CowboyTim/halloween-bang/docs/61XBP4-2t9L._AC_SL1001_.jpg

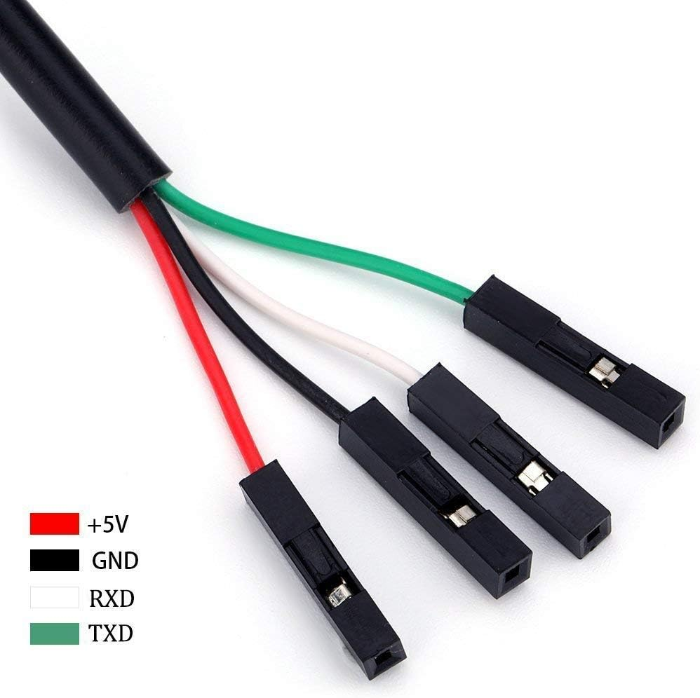
docs/61XBP4-2t9L._AC_SL1001_.jpg
