CowboyTim/halloween-bang/docs/2n2222-npn-transistor-pinout-diagram.jpg

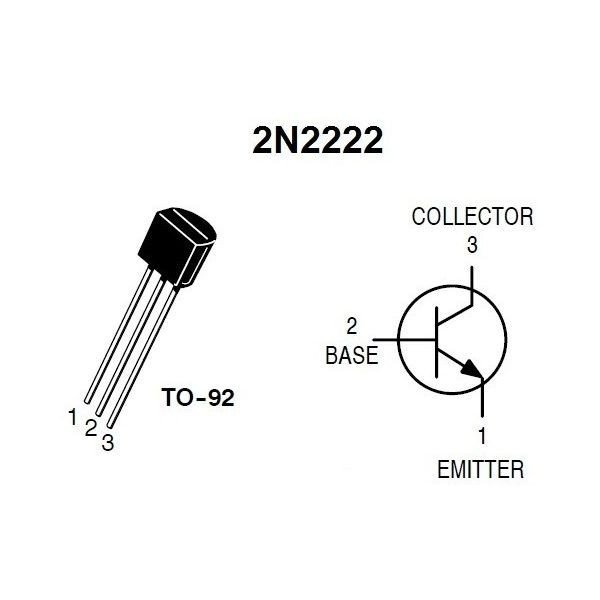
docs/2n2222-npn-transistor-pinout-diagram.jpg
