CowboyTim/halloween-bang/docs/button_schema.jpeg

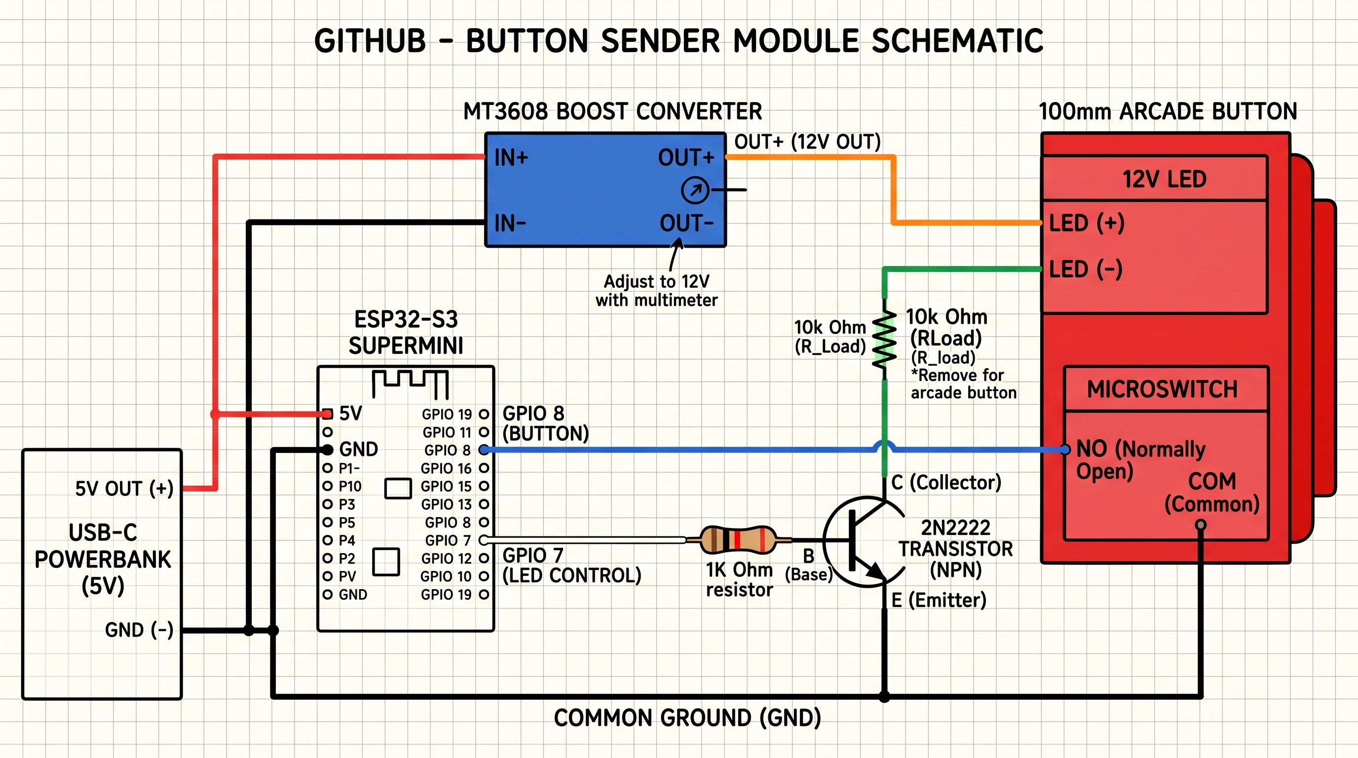
docs/button_schema.jpeg
