CowboyTim/halloween-bang/docs/dfplayer_pinout.webp

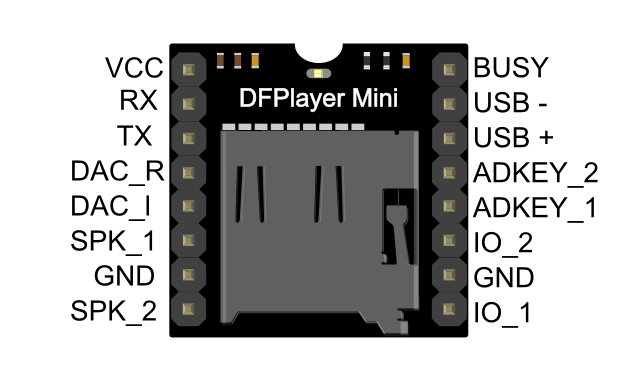
docs/dfplayer_pinout.webp
