CowboyTim/halloween-bang/docs/esp32s3_supermini_pinout.png

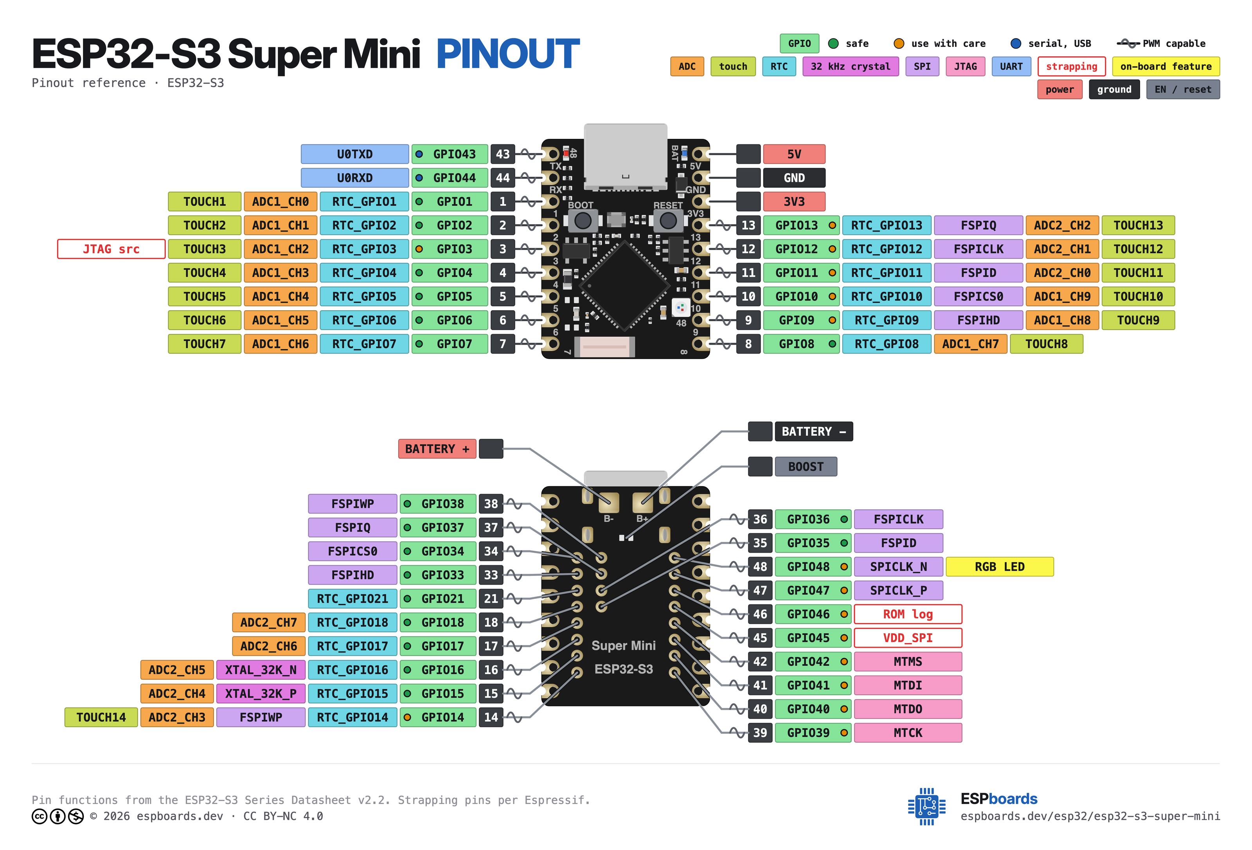
docs/esp32s3_supermini_pinout.png
