CowboyTim/halloween-bang/docs/onoff-button-white-led.jpg

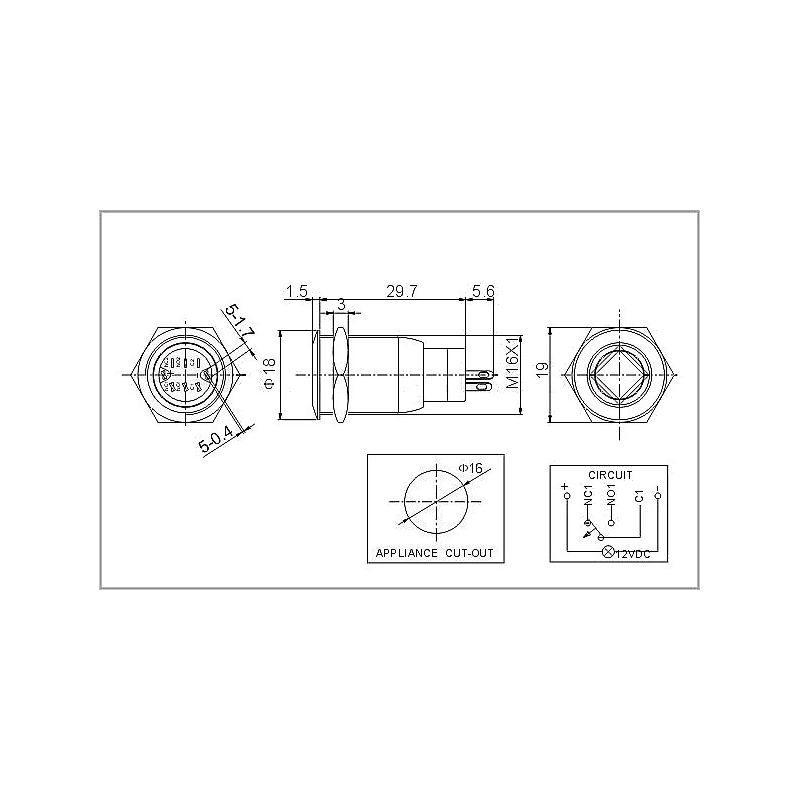
docs/onoff-button-white-led.jpg
