CowboyTim/halloween-bang/esp32s3_zero.pinout.png

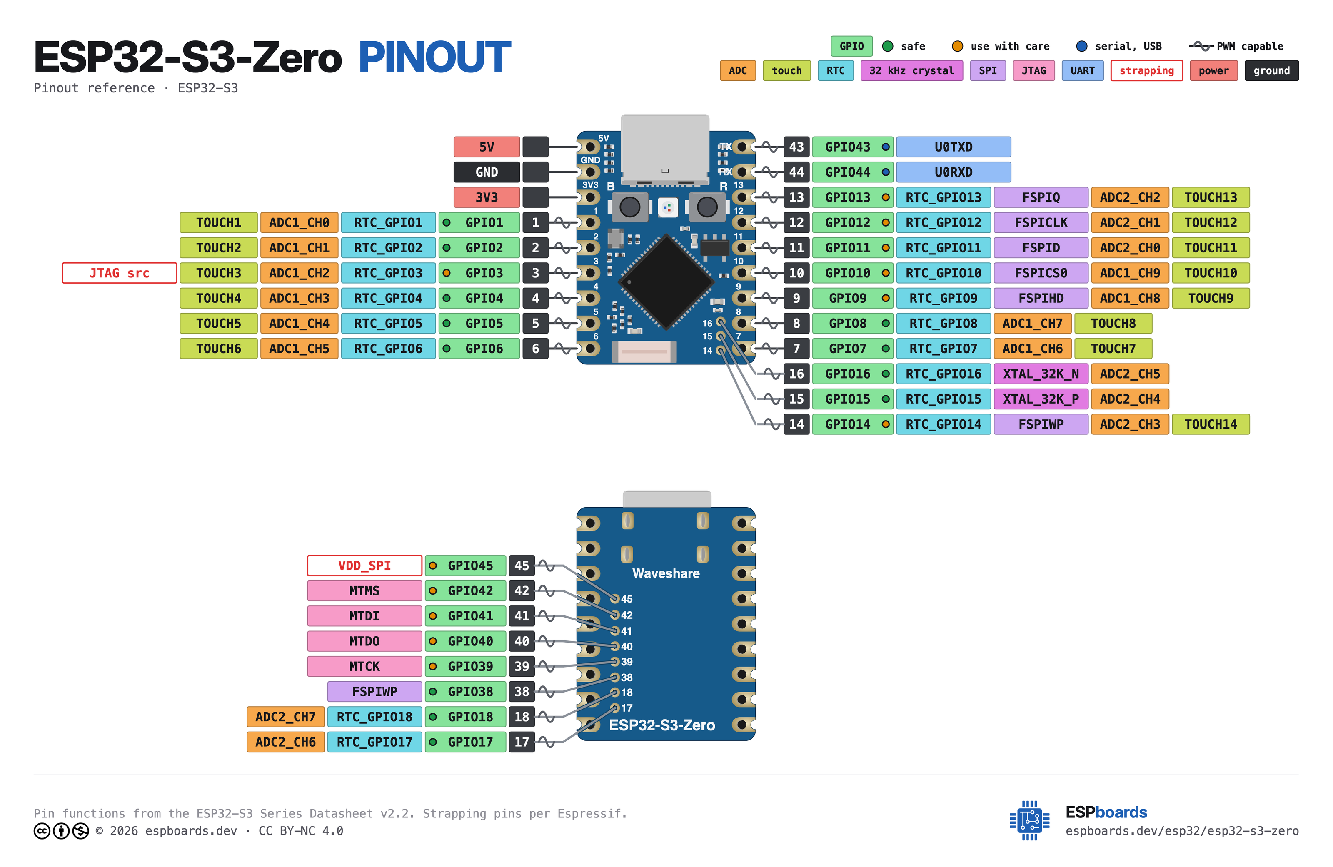
esp32s3_zero.pinout.png
