CowboyTim/halloween-bang/halloween-bang/halloween-bang.ino

#ifndef UART_LOG_DEV_UART0
#define UART_LOG_DEV_UART0 0
#endif

#if UART_LOG_DEV_UART0 == 1
 #define NO_GLOBAL_INSTANCES
 #define NO_GLOBAL_SERIAL
 #include <HardwareSerial.h>
 extern HardwareSerial Serial0;
 extern HardwareSerial Serial1;
 #define UART0         Serial0
 #define Serial        Serial0
 #define UART1         Serial1
#else
 #include <HardwareSerial.h>
 #define UART0         Serial
 #define UART1         Serial1
#endif // UART_LOG_DEV_UART0

// 433 MHz link (RadioHead): only the BUTTON (receiver) uses it. The KILLSWITCH has no STX882 fitted,
// so it sends over ESP-NOW only (its 433 MHz transmit path is compiled out).
#if defined(BUTTON)
#define USE_RF433 1
#else
#define USE_RF433 0
#endif

#include <stdlib.h>
#include "EdSoftLED.h"
#if defined(ESP8266)
  #include <ESP8266WiFi.h>
  #include <espnow.h>
  #error "This board is not supported or is missing Wi-Fi hardware!"
#elif defined(ESP32)
  #include <WiFi.h>
  #include <esp_wifi.h>
  #include <esp_now.h>
  #include <driver/gpio.h>
  #include <driver/rmt.h>
  #include <esp_task_wdt.h>
  #include <soc/gpio_struct.h>
  #if USE_RF433
  #include <RH_ASK.h>        // 433 MHz ASK link (STX882 / SRX882): a second path for LOCK / FREE
  #include <SPI.h>
  #endif
  #include <esp_rom_sys.h>
  // ESP32 fallback if needed
#else
  #error "This board is not supported or is missing Wi-Fi hardware!"
#endif

#include "HardwareSerial.h"
// The BANGER has no DFPlayer by default: the EXPLOSION boxes play the sounds, and the show never waits for
// them. -DBANGER_DFPLAYER (bang.py build banger --flags=-DBANGER_DFPLAYER) puts a DFPlayer back on the BANGER.
#if defined(EXPLOSION) || (defined(BANGER) && defined(BANGER_DFPLAYER))
#define HAS_DFPLAYER 1
#include "DFRobotDFPlayerMini.h"
#endif

#ifdef EXPLOSION
#define SOUND_VOLUME        20  // EXPLOSION box, DFPlayer volume 0-30: same as the BANGER (was 10 while its DFPlayer ran from 3.3 V)
#else
#define SOUND_VOLUME        20  // BANGER, DFPlayer volume 0-30
#endif
#define SOUND_1             1
#if (defined(EXPLOSION) || defined(STROBO)) && CONFIG_IDF_TARGET_ESP32C3
#define EXPL_LED_PIN        GPIO_NUM_8  // EXPLOSION / STROBO (C3): built-in blue LED, lit when LOW
#define EXPL_LED_ON         LOW
#endif
#define EXPL_RETRY_MS       5000        // EXPLOSION: search for the DFPlayer this often while it is missing
#define EXPL_BLINK_MS       300         // EXPLOSION: LED blink half-period while the DFPlayer is missing
#define EXPL_FLICKER_MS     50          // EXPLOSION: LED flicker step while a sound plays (random on/off every step)
#define EXPL_PLAY_GRACE_MS  400         // EXPLOSION: BUSY goes low a moment after "play", flicker from the command on
#define SOUND_2             2
#if defined(EXPLOSION) && CONFIG_IDF_TARGET_ESP32C3
// EXPLOSION sound box on a C3 SuperMini (free pins, UART1)
#define DFPLAYER_UART_NR    1
#define DFPLAYER_BUSY_PIN   GPIO_NUM_3  // on EXPLOSION (C3): DFPlayer BUSY
#define DFPLAYER_TX_PIN     GPIO_NUM_5  // on EXPLOSION (C3): to DFPlayer RX
#define DFPLAYER_RX_PIN     GPIO_NUM_6  // on EXPLOSION (C3): from DFPlayer TX
#else
#define DFPLAYER_UART_NR    2
#define DFPLAYER_BUSY_PIN   GPIO_NUM_7  // on BANGER (and EXPLOSION on an S3)
#define DFPLAYER_TX_PIN     GPIO_NUM_12 // on BANGER (and EXPLOSION on an S3)
#define DFPLAYER_RX_PIN     GPIO_NUM_13 // on BANGER (and EXPLOSION on an S3)
#endif

// The light show must run without the DFPlayer (not wired, no SD card, BUSY stuck LOW):
// boot gives up on it after these limits and the show then runs on its own timers.
#define DFPLAYER_INIT_TRIES       3     // begin() attempts at boot (each takes ~2-3 s)
#define DFPLAYER_BUSY_TIMEOUT_MS  3000  // boot: BUSY must go HIGH (idle) within this time
#define SOUND_END_TIMEOUT_MS      2000  // show: wait at most this long for a sound to end after its animation

#define BUILTIN_LED         GPIO_NUM_21 // S3 Zero: one WS2812 RGB LED (BANGER status LED, see ws2812_write(); not usable through RMT, the strip owns it)
#define BUTTON_PIN          GPIO_NUM_8  // on BUTTON
#define LED_12V_PIN         GPIO_NUM_7  // on BUTTON

// KILLSWITCH pins, per chip. The unit needs no LED of its own: the board's built-in LED shows
// that a press was seen and sent; the BUTTON's lamp shows the actor what the button is doing.
#if CONFIG_IDF_TARGET_ESP32C3
// ESP32-C3 SuperMini. Not usable: 2/8/9 strapping (8 = built-in LED, 9 = BOOT button),
// 12-17 SPI flash, 18/19 USB, 20/21 UART0. Free: 0, 1, 3, 4, 5, 6, 7, 10.
#define KILL_BUTTON_PIN     GPIO_NUM_3  // external push button to GND (internal pull-up)
#define KILL_BOOT_PIN       GPIO_NUM_9  // on-board BOOT button works too (held while powering up = flash mode)
#define KILL_LED_PIN        GPIO_NUM_8  // built-in blue LED
#define KILL_LED_ON         LOW         // it is lit when the pin is LOW
#define KILL_EXT_LED_PIN    GPIO_NUM_10 // LED in the lock switch (3-6 V type, direct from the pin), follows the built-in LED; lit when HIGH
// Wi-Fi TX power of the C3. Lower power was tried (8.5 dBm); at 7 m the reception was about
// the same at every level, so full power is kept (measured at the BUTTON, 2026-10-15).
#define KILL_TX_POWER       WIFI_POWER_19_5dBm
#else
// ESP32-S3 SuperMini
#define KILL_BUTTON_PIN     GPIO_NUM_8  // push button to GND (internal pull-up)
#define KILL_BOOT_PIN       GPIO_NUM_0  // on-board BOOT button works too
#define KILL_LED_PIN        GPIO_NUM_7  // optional LED, 330 ohm to GND
#define KILL_LED_ON         HIGH
#endif

#define WAIT_TIME_BUTTON    16000       // configurable wait time (ms) for button mode - time of animation the banger is showing (whole show is ~14.5s: 0001.mp3 10.3s + 0002.mp3 4.0s)
// After every show both sides rest for SHOW_COOLDOWN_MS, then start fresh: the BANGER drops every BANG that
// arrives in that time, the BUTTON ignores the button (lamp dark) until WAIT_TIME_BUTTON + SHOW_COOLDOWN_MS.
// So whatever goes wrong at the button (a stuck contact, a loose wire), shows cannot follow each other
// back to back. The BUTTON's total wait must stay longer than the BANGER's show + cooldown.
#ifndef SHOW_COOLDOWN_MS
#define SHOW_COOLDOWN_MS    60000
#endif

#define IS_BUTTON     1
#define IS_BANGER     2
#define IS_KILLSWITCH 3
#define IS_EXPLOSION  4     // sound box only: plays the sounds the BANGER announces (SND1 / SND2)
#define IS_STROBO     5     // strobe box only: runs the KABOOM strobe burst when the BANGER says "STRB"
#if CONFIG_IDF_TARGET_ESP32C3 && (defined(BANGER) || defined(BUTTON))
#error "BANGER and BUTTON pins are for the ESP32-S3 (GPIO 12/13 are flash pins on the C3); only KILLSWITCH has C3 pins"
#endif
#ifdef BUTTON
uint8_t WHAT = IS_BUTTON;
#endif
#ifdef BANGER
uint8_t WHAT = IS_BANGER;
#endif
#ifdef KILLSWITCH
uint8_t WHAT = IS_KILLSWITCH;
#endif
#ifdef EXPLOSION
uint8_t WHAT = IS_EXPLOSION;
#endif
#ifdef STROBO
uint8_t WHAT = IS_STROBO;
#endif

// Two 5 m strips in one chain (600 LEDs): the fuse is LEDs 0-419 (7 m), the ring stays the last 180 LEDs.
#define LINE_START    0
#define LINE_END    419
#define RING_START  420
#define RING_END    599

#define STROBE_PIN          GPIO_NUM_5  // STROBO box only: gate of the logic-level N-MOSFET that switches the flash (100-220R in series, 10k pull-down to GND)

#define LED_STRIP_GPIO_PIN  GPIO_NUM_4  // data pin to DIN on the strip
#define NUM_LEDS                   600  // two 5 m strips (60 LED/m) in one chain; can be shorter
EdSoftLED strip(NUM_LEDS, LED_STRIP_GPIO_PIN, WS2812GRB);

#ifdef HAS_DFPLAYER
HardwareSerial DFPLayerSerial(DFPLAYER_UART_NR);
DFRobotDFPlayerMini myDFPlayer;
#endif

uint8_t animation_is_running = 0;
uint8_t trigger_animation = 0;
uint8_t sound_ok = 0;              // BANGER: 1 = DFPlayer found and BUSY works, 0 = lights only
unsigned long last_activity = 0;
#ifndef BANGER_MAC                   // bang.py sets it from boards.toml
#define BANGER_MAC 0xe4, 0xb3, 0x23, 0xf9, 0x43, 0xf0
#endif
uint8_t receiverAddress[] = {BANGER_MAC};
// Optional add-on boxes the BANGER tells about the show. bang.py passes one MAC per board of that
// role in boards.toml (flat list of bytes, EXPLOSION_COUNT / STROBO_COUNT boxes).
#ifdef EXPLOSION_MACS                // sound boxes: the BANGER announces each sound it starts
uint8_t explosionAddress[EXPLOSION_COUNT][6] = { EXPLOSION_MACS };
#endif
#ifdef STROBO_MACS                   // strobe boxes: the BANGER says when the KABOOM strobe starts
uint8_t stroboAddress[STROBO_COUNT][6] = { STROBO_MACS };
#endif
volatile uint8_t snd_req = 0;        // EXPLOSION: SOUND_1 or SOUND_2 announced by the BANGER
volatile uint8_t strb_req = 0;       // STROBO: "STRB" received
#ifdef TEST_SERIAL
uint8_t  test_pin_mode = 0;         // BUTTON test build: 0 = the real pin, 1 = held LOW ("hold"), 2 = chatter ("chatter")
uint32_t test_press_until = 0;      // BUTTON test build: "fire" reads the pin LOW until then (a clean 100 ms press)
#endif

#define WATCHDOG_TIMEOUT_MS 60000   // 60s
esp_task_wdt_user_handle_t wdt_user_handle;

#define doYIELD myYIELD()

#define LOG(...)        _log_l(__VA_ARGS__);
#define NOINLINE        __attribute__((noinline,noipa))
#define INLINE          __attribute__((always_inline))
#define ALIGN(x)        __attribute__((aligned(x)))
#define LOG_TIME_FORMAT "[\%H:\%M:\%S][info]: "

#ifdef LOG_VERBOSE
uint8_t verbose = 1;
#else
uint8_t verbose = 0;
#endif

NOINLINE
const char * PT(const char *tformat) {
  ALIGN(4) static char T_buffer[512] = {""};
  static time_t t = 0;
  static struct tm gm_new_tm = {0};
  time(&t);
  if(localtime_r(&t, &gm_new_tm) == NULL) {
    T_buffer[0] = 0;
    return (const char *)&T_buffer;
  }
  memset(T_buffer, 0, sizeof(T_buffer));
  size_t s = strftime(T_buffer, sizeof(T_buffer), tformat, &gm_new_tm);
  if(s == 0)
    T_buffer[0] = 0;
  return (const char *)&T_buffer;
}

// Logging goes to the S3's USB serial (HWCDC) in the normal build. Its write() blocks up to
// ~2 s per call when the PC is plugged in but nothing reads (monitor closed), which stalls
// the show. So: no TX wait (setTxTimeoutMs(0) in setup()), a bigger TX buffer for bursts, one
// write per line, and a line that does not fit is dropped whole. LOG() never blocks.
#if ARDUINO_USB_CDC_ON_BOOT && ARDUINO_USB_MODE && UART_LOG_DEV_UART0 == 0
 #define LOG_USB_HWCDC  1
 #define LOG_TX_BUFFER  2048
#else
 #define LOG_USB_HWCDC  0
#endif

NOINLINE
void LOGPRINT(const char *buf, size_t len){
    if(!verbose || len == 0)
        return;
    #if ARDUINO_USB_CDC_ON_BOOT
      if (!Serial) return; // no USB host (e.g. power bank): skip logging
    #endif
    #if LOG_USB_HWCDC
      if (Serial.availableForWrite() < (int)len) return; // PC not reading: drop the line
    #endif
    UART0.write((const uint8_t *)buf, len);
}

NOINLINE
void do_vprintf(uint8_t t, const char *tf, const char *_fmt, va_list args) {
  // timestamp + text + newline in one buffer, written in one go
  ALIGN(4) static char obuf[320] = {0};
  if(_fmt == NULL && tf == NULL)
    return;
  size_t n = 0;
  if((t & 2) && tf != NULL) {
    n = strlcpy(obuf, PT(tf), sizeof(obuf));
    if(n >= sizeof(obuf))
      n = sizeof(obuf) - 1;
  }
  if(_fmt != NULL) {
    int s = vsnprintf(obuf + n, sizeof(obuf) - n, _fmt, args);
    if(s > 0)
      n += ((size_t)s < sizeof(obuf) - 1 - n) ? (size_t)s : sizeof(obuf) - 1 - n;
    if(t & 1) {
      if(n > sizeof(obuf) - 2)
        n = sizeof(obuf) - 2;
      obuf[n++] = '\n';
    }
  }
  obuf[n] = 0;
  LOGPRINT(obuf, n);
}

NOINLINE
void do_printf(uint8_t t, const char *tf, const char *_fmt, ...) {
  va_list args;
  va_start(args, _fmt);
  do_vprintf(t, tf, _fmt, args);
  va_end(args);
}

NOINLINE
void _log_l(const char *fmt, ...) {
  va_list args;
  va_start(args, fmt);
  do_vprintf(3, LOG_TIME_FORMAT, fmt, args);
  va_end(args);
}


void setup_cpu_speed(uint32_t freq_mhz = 160) {
  uint32_t xtal_f = getXtalFrequencyMhz();
  uint32_t cpu_f = getCpuFrequencyMhz();
  LOG("[ESP] Current CPU frequency: %d MHz", cpu_f);
  if(xtal_f != 0) {
    LOG("[ESP] Detected XTAL frequency: %d MHz", xtal_f);
    if(xtal_f != 40) {
      LOG("[ESP] Warning: Unusual XTAL frequency detected, expected 40 MHz");
    } else {
      if(xtal_f == 40) {
        // 40 MHz XTAL, set CPU to 80, 160
        // 40 MHz XTAL also allows 10, 20, 40 MHz CPU
        cpu_f = freq_mhz;
        LOG("[ESP] Setting CPU frequency to %d MHz for %d MHz XTAL", cpu_f, xtal_f);
        setCpuFrequencyMhz(cpu_f);
      }
      cpu_f = getCpuFrequencyMhz();
      LOG("[ESP] Current CPU frequency: %d MHz", cpu_f);
    }
  } else {
    LOG("[ESP] Failed to detect XTAL frequency, defaulting to 40 MHz");
  }
}

#if USE_RF433
// 433 MHz ASK link for LOCK / FREE, next to ESP-NOW (either one is enough: both feed the same lock timer).
// BUTTON: SRX882 DATA through 1 kohm on RF433_RX_PIN, 5 V. (The KILLSWITCH's STX882 on RF433_TX_PIN is not used.)
// RadioHead configures all three pins, so none of them may be used for anything else (the lamp is GPIO 7).
#define RF433_BITRATE   2000    // bits per second; one packet takes about 70 ms on the air
#define RF433_TX_PIN    4
#define RF433_RX_PIN    6
#define RF433_PTT_PIN   5       // unused
RH_ASK  rf433(RF433_BITRATE, RF433_RX_PIN, RF433_TX_PIN, RF433_PTT_PIN);
uint8_t rf433_ok = 0;           // 1 = RadioHead initialised, 0 = ESP-NOW only
#endif
#define LINK_ESPNOW     1
#define LINK_433        2
#define LINK_WIRED      4
volatile uint8_t lock_links = 0;   // BUTTON: which links delivered LOCKs during the current lock (logged on release)

// ==== MESSAGES BEGIN ====
// ESP-NOW messages (exact match, the payload is not NUL terminated):
//   "BANG"      BUTTON     -> BANGER      start the show
//   "LOCK"      KILLSWITCH -> BUTTON      repeated while the killswitch is held: keep the button locked
//   "FREE"      KILLSWITCH -> BUTTON      killswitch released: unlock now (else the lock times out)
//   "SND1"      BANGER     -> EXPLOSION   the BANGER starts 0001.mp3 (the fuse), play it too
//   "SND2"      BANGER     -> EXPLOSION   the BANGER starts 0002.mp3 (the KABOOM), play it too
//   "STRB"      BANGER     -> STROBO      the KABOOM animation starts: run the strobe burst
volatile uint32_t lock_seen_ms    = 0;   // BUTTON: millis() of the last "LOCK" (0 = none / freed)
uint8_t broadcastAddress[] = {0xff, 0xff, 0xff, 0xff, 0xff, 0xff};

static bool msg_is(const uint8_t *msg, int len, const char *s) {
  return len == (int)strlen(s) && memcmp(msg, s, len) == 0;
}

// LOCK / FREE from either link (the ESP-NOW callback or the 433 MHz poll): both end up in the same lock timer
static void apply_lock_msg(const uint8_t *msg, int len, uint8_t link) {
  if(msg_is(msg, len, "LOCK")) {
    lock_links |= link;
    uint32_t t = millis();
    lock_seen_ms = t ? t : 1;
  } else if(msg_is(msg, len, "FREE")) {
    lock_links |= link;
    lock_seen_ms = 0;
  }
}

volatile uint32_t bang_rx = 0;      // BANGER: BANG messages received (copies included), for the log
uint8_t bang_src[6] = {0};           // BANGER: MAC of the last BANG sender (which BUTTON started the show)
uint32_t show_end_ms = 0;            // BANGER: when the last show ended (0 = none yet)
bool banger_cooling(){ return show_end_ms && millis() - show_end_ms < SHOW_COOLDOWN_MS; }

void OnDataRecv(const esp_now_recv_info_t *mac, const uint8_t *msg, int len) {
  if(msg_is(msg, len, "BANG")) {
    bang_rx++;
    if(mac && mac->src_addr) memcpy(bang_src, mac->src_addr, 6);
    trigger_animation = 1;
  } else if(msg_is(msg, len, "LOCK") || msg_is(msg, len, "FREE")) {
    apply_lock_msg(msg, len, LINK_ESPNOW);
  } else if(msg_is(msg, len, "SND1")) {
    snd_req = SOUND_1;
  } else if(msg_is(msg, len, "SND2")) {
    snd_req = SOUND_2;
  } else if(msg_is(msg, len, "STRB")) {
    strb_req = 1;
  }
}
// ==== MESSAGES END ====

// only yields; the watchdog is fed once per loop() pass (wdt_feed), so a wait that never
// ends inside a function is not hidden from it
#ifdef BANGER
// ---- BANGER status LED: the S3 Zero's WS2812 on BUILTIN_LED ---------------------------------
// Bit-banged, because the RMT channels belong to the strip (neopixelWrite() fails). One pixel is
// 24 bits, about 30 us with interrupts off on this core. Only written when the colour changes.
// Called from myYIELD(), so it also runs inside the show's loops (they yield every frame).
#define BLED_FLICKER_MS  50      // random on/off step while the show runs
#define BLED_BLINK_MS    300     // blink half-period while the DFPlayer is missing
portMUX_TYPE bled_mux = portMUX_INITIALIZER_UNLOCKED;
uint32_t bled_last = 0xFFFFFFFF;

void ws2812_write(uint8_t r, uint8_t g, uint8_t b){
  const uint32_t mask = 1UL << BUILTIN_LED;
  const uint32_t mhz  = getCpuFrequencyMhz();                       // CPU cycles per microsecond
  const uint32_t t0h = mhz * 4 / 10, t1h = mhz * 8 / 10, tbit = mhz * 125 / 100;   // 0.4 / 0.8 / 1.25 us
  const uint32_t grb = ((uint32_t)g << 16) | ((uint32_t)r << 8) | b;
  portENTER_CRITICAL(&bled_mux);
  for(int i = 23; i >= 0; i--){
    uint32_t high = ((grb >> i) & 1) ? t1h : t0h;
    uint32_t t = ESP.getCycleCount();
    GPIO.out_w1ts = mask;
    while(ESP.getCycleCount() - t < high) {}
    GPIO.out_w1tc = mask;
    while(ESP.getCycleCount() - t < tbit) {}
  }
  portEXIT_CRITICAL(&bled_mux);
}

void banger_led_update(){
  uint32_t now = millis();
  uint8_t r = 0, g = 0, b = 0;
  if(animation_is_running){
    if((((now / BLED_FLICKER_MS) * 2654435761u) >> 24) & 1){ r = 40; g = 8; }   // flicker (orange) while the show runs
#ifdef BANGER_DFPLAYER
  } else if(!sound_ok){
    if((now / BLED_BLINK_MS) & 1){ r = 24; g = 16; }                            // blink (yellow): DFPlayer missing
#endif
  } else if(banger_cooling()){
    b = 12;                                                                     // dim blue: cooldown, BANGs are dropped
  } else {
    g = 10;                                                                     // dim green: ready
  }
  uint32_t c = ((uint32_t)r << 16) | ((uint32_t)g << 8) | b;
  if(c == bled_last) return;
  bled_last = c;
  ws2812_write(r, g, b);
}
#endif

void myYIELD(){
  yield();
#ifdef BANGER
  banger_led_update();
#endif
}

void wdt_feed(){
  if(wdt_user_handle != NULL){
      esp_err_t ok = esp_task_wdt_reset_user(wdt_user_handle);
      if(ok != ESP_OK) {
        LOG("[WDT] Failed to reset WDT: %s", esp_err_to_name(ok));
      }
  }
}

uint8_t printed_ready = 0;
uint8_t button_was_pressed = 0;
portMUX_TYPE r_mux = portMUX_INITIALIZER_UNLOCKED;

void IRAM_ATTR button_pressed() {
  portENTER_CRITICAL_ISR(&r_mux);
  button_was_pressed = 1;
  portEXIT_CRITICAL_ISR(&r_mux);
}

// ==== BUTTON / KILLSWITCH BEGIN ====
// -------------------------------------------------------------------------
//  Three units talk over ESP-NOW. LOCK / FREE use broadcast, so the KILLSWITCH needs no MAC
//  address. The BUTTON sends nothing back: its lamp shows the actor what it is doing.
//
//    KILLSWITCH --"LOCK" (stream while locked) / "FREE"-->  BUTTON  --"BANG"-->  BANGER
//
//  The lock is kept alive by the KILLSWITCH (a dead-man switch): while it is in locked mode it
//  sends "LOCK" every KILL_LOCK_PERIOD_MS, and the BUTTON is LOCKED while LOCKs keep arriving. A
//  press of the KILLSWITCH toggles the mode; leaving it sends "FREE" (KILL_REPEATS times). There is
//  no timer in the lock itself: it lasts as long as the act needs. If the KILLSWITCH stops, is
//  unplugged, resets or runs flat, the stream stops and the BUTTON unlocks LOCK_TIMEOUT_MS later.
//  No KILLSWITCH = never locked, and at boot the KILLSWITCH is unlocked and silent.
//
//  Button states:
//    boot -> READY --press--> SHOW --(WAIT_TIME_BUTTON)--> READY (LOCKED if still locked)
//    READY --LOCK--> LOCKED --(no LOCK for LOCK_TIMEOUT_MS, or FREE; button released)--> READY
//    A LOCK during SHOW does not stop the show (it already runs on the BANGER).
//    Presses in any state except READY are thrown away.
//
//  KILLSWITCH unit: ONE push button or switch. Its built-in LED is on while it is locked, and
//  blinks once at power-up.
// -------------------------------------------------------------------------

#define LOCK_TIMEOUT_MS        1000    // BUTTON: LOCKED until no "LOCK" arrived for this long
#define KILL_LOCK_PERIOD_MS    150     // KILLSWITCH: "LOCK" is repeated this often while held (several may get lost)
// Wired killswitch on the BUTTON: a normally-open switch to GND on a long cable (up to about 10 m), held = locked,
// OR'ed with the radio killswitch. A long wire picks up noise and a false lock blocks the button, so the line must
// stay LOW for WIRED_KILL_ENGAGE_MS before it counts; releasing is quick. Wiring (see the BUTTON schematic): twisted
// pair, 2.2 kohm pull-up to 3.3 V at this end (the internal one is too weak for a long wire), 1 kohm in series
// with the pin and 100 nF from the pin to GND. Unlike the radio lock, the wired one ends by itself after
// WIRED_LOCK_MAX_MS (a stuck or shorted wire must not block the button for good).
#define WIRED_KILL_PIN         GPIO_NUM_1   // on BUTTON
#define WIRED_KILL_ENGAGE_MS   100          // LOW at least this long = held
#define WIRED_KILL_RELEASE_MS  30           // HIGH at least this long = released
#define WIRED_LOCK_MAX_MS      30000        // wired lock ignored after this long held, until released

// BUTTON lamp (12 V via the 2N2222 on LED_12V_PIN, PWM)
#define LAMP_PWM_FREQ          2000    // Hz
#define LAMP_PWM_BITS          8
#define LAMP_LOCKED_LEVEL      0       // 0-255, lamp while locked (0 = dark, a few units = faint ember)
#define LAMP_BREATH_MIN        4       // 0-255, darkest point of the "press me" breathing
#define LAMP_BREATH_PERIOD_MS  3000    // one breath in and out
#define LAMP_SHOW_PERIOD_MS    100     // flicker while the show runs (half on, half off)

// KILLSWITCH / BUTTON sends
#define BANG_REPEATS           3       // BUTTON -> BANGER: "BANG" is sent this many times, the BANGER starts one show only
#define BANG_REPEAT_GAP_MS     60
#define KILL_REPEATS           3       // "FREE" is sent this many times (broadcast has no retries)
#define KILL_FREE_GAP_MS       100     // gap between the FREE copies (a 433 MHz packet takes about 70 ms)
#define KILL_BLINK_MS          300     // KILLSWITCH LED: the power-up blink

enum { BS_LOCKED = 0, BS_READY = 2, BS_SHOW = 3 };

// Lamp brightness (0-255) for a button state; ms = time since that state began.
uint8_t lamp_level(uint8_t state, uint32_t ms) {
  switch (state) {
    case BS_LOCKED:
      return LAMP_LOCKED_LEVEL;
    case BS_READY: {
      // slow breathing = "press me"; b*b approximates the eye's brightness curve
      float b = 0.5f - 0.5f * cosf(2.0f * PI * (float)(ms % LAMP_BREATH_PERIOD_MS) / LAMP_BREATH_PERIOD_MS);
      return (uint8_t)(LAMP_BREATH_MIN + (255 - LAMP_BREATH_MIN) * b * b);
    }
    case BS_SHOW:
      if (ms >= WAIT_TIME_BUTTON) return 0;   // the show is over: dark for the cooldown
      return ((ms % LAMP_SHOW_PERIOD_MS) < LAMP_SHOW_PERIOD_MS / 2) ? 255 : 0;
  }
  return 0;
}

// ---- BUTTON unit ---------------------------------------------------------
uint8_t  bstate            = BS_READY;   // works out of the box
uint32_t bstate_since      = 0;
uint32_t button_high_since = 0;     // millis() since the button was last seen released (0 = pressed now)
uint32_t button_low_since  = 0;     // millis() since the button was last seen pressed (0 = released now)
uint8_t  button_armed      = 0;     // 1 = released long enough: the next LOW of PRESS_MIN_MS is a press
uint32_t button_glitches   = 0;     // falling edges (interrupt) that did not become a press: noise, chatter
uint32_t button_glitch_log_ms = 0;
// A press counts only when the pin is LOW for PRESS_MIN_MS after it was HIGH (released) for RELEASE_MIN_MS.
// A noise spike (the lamp PWM, a loose wire) or a stuck / chattering contact then cannot start shows on
// its own, and a button that is still held after a show must be let go before it can start the next one.
#define PRESS_MIN_MS        30
#define RELEASE_MIN_MS      50
#define BUTTON_STUCK_MS     2000    // held this long after its press = stuck: the lamp flickers
uint8_t button_stuck_shown = 0;

uint8_t button_level(){
#ifdef TEST_SERIAL
  uint32_t t = millis();
  if (test_press_until && (int32_t)(test_press_until - t) > 0) return LOW;
  test_press_until = 0;
  if (test_pin_mode == 1) return LOW;
  if (test_pin_mode == 2) return ((t / 5) & 1) ? LOW : HIGH;
#endif
  return digitalRead(BUTTON_PIN);
}
uint32_t last_lamp_ms      = 0;
uint8_t  bang_repeats_left = 0;     // BANG copies still to send
uint32_t bang_next_ms      = 0;

void button_set_state(uint8_t s) {
  if (s == bstate) return;
  LOG("BUTTON state %d -> %d", bstate, s);
  bstate       = s;
  bstate_since = millis();
}

void button_setup(){
  // peer: the BANGER (gets "BANG")
  esp_now_peer_info_t peerInfo = {};
  memcpy(peerInfo.peer_addr, receiverAddress, 6);
  peerInfo.channel = 0;
  peerInfo.encrypt = false;
  esp_now_add_peer(&peerInfo);
  // "LOCK" and "FREE" come from the KILLSWITCH
  esp_now_register_recv_cb(OnDataRecv);

  LOG("button INPUT_PULLUP PIN: %d", BUTTON_PIN);
  pinMode(BUTTON_PIN, INPUT_PULLUP);
  pinMode(WIRED_KILL_PIN, INPUT_PULLUP);   // plus the external 2.2 kohm pull-up on a long cable
  LOG("wired killswitch input on GPIO %d", WIRED_KILL_PIN);
  // Attach interrupt on FALLING edge (when the button pulls the pin to GND)
  attachInterrupt(digitalPinToInterrupt(BUTTON_PIN), button_pressed, FALLING);

  // minimal 80MHz, else ESP-NOW doesnt work on esp32s3
  setup_cpu_speed(80);

#if USE_RF433
  // 433 MHz receiver (second path for LOCK / FREE)
  rf433_ok = rf433.init();
  LOG("433 MHz receiver %s (SRX882 DATA on GPIO %d)", rf433_ok ? "ready" : "init FAILED, ESP-NOW only", RF433_RX_PIN);
#endif

  // 12V lamp: PWM so it can fade (set up after the CPU speed change)
  ledcAttach(LED_12V_PIN, LAMP_PWM_FREQ, LAMP_PWM_BITS);
  ledcWrite(LED_12V_PIN, lamp_level(bstate, 0));
  bstate_since = millis();
}

// ==== WIRED KILL BEGIN ====
uint32_t wired_low_since  = 0;     // millis() when the pin last went LOW (0 = it is HIGH)
uint32_t wired_high_since = 0;     // millis() when the pin last went HIGH (0 = it is LOW)
uint32_t wired_since      = 0;     // millis() when the current hold began
uint8_t  wired_active     = 0;     // 1 = the wired killswitch is held
uint8_t  wired_expired    = 0;     // 1 = held for WIRED_LOCK_MAX_MS: ignored until the pin has been HIGH

// LOW (switch to GND) for WIRED_KILL_ENGAGE_MS = held, HIGH for WIRED_KILL_RELEASE_MS = released. It never lasts
// longer than WIRED_LOCK_MAX_MS: a stuck or shorted wire is ignored until it goes HIGH again.
// A cut wire reads HIGH (pull-up) = not held, so the button works.
static bool wired_kill_held(uint32_t now, int level){
  if (level == LOW) {
    wired_high_since = 0;
    if (!wired_low_since) wired_low_since = now ? now : 1;
    if (!wired_active && !wired_expired && now - wired_low_since >= WIRED_KILL_ENGAGE_MS) {
      wired_active = 1;
      wired_since  = now ? now : 1;
      LOG("wired killswitch held");
    }
  } else {
    wired_low_since = 0;
    if (!wired_high_since) wired_high_since = now ? now : 1;
    if (now - wired_high_since >= WIRED_KILL_RELEASE_MS) {
      if (wired_active) LOG("wired killswitch released");
      wired_active  = 0;
      wired_expired = 0;
    }
  }
  if (wired_active && now - wired_since >= WIRED_LOCK_MAX_MS) {
    LOG("wired killswitch held for %d s: lock expired, ignored until it is released", WIRED_LOCK_MAX_MS / 1000);
    wired_active  = 0;
    wired_expired = 1;
  }
  if (wired_active) lock_links |= LINK_WIRED;
  return wired_active;
}
// ==== WIRED KILL END ====

// 433 MHz: LOCK / FREE from the KILLSWITCH's second link, polled every pass (the receive ISR collects them)
static void rf433_poll(){
#if USE_RF433
  if(!rf433_ok) return;
  uint8_t buf[RH_ASK_MAX_MESSAGE_LEN];
  uint8_t len = sizeof(buf);
  if(rf433.recv(buf, &len))
    apply_lock_msg(buf, len, LINK_433);
#endif
}

void do_button_loop(){
  uint32_t now = millis();
  rf433_poll();

  // Inputs. A press is detected on every pass and used only while READY, so nothing piles up while
  // it is not its turn (a press during LOCKED / SHOW is simply gone).
  uint8_t level = button_level();
  if (level == HIGH) {
    if (!button_high_since) button_high_since = now ? now : 1;
    button_low_since = 0;
    if (!button_armed && now - button_high_since >= RELEASE_MIN_MS) button_armed = 1;
  } else {
    button_high_since = 0;
    if (!button_low_since) button_low_since = now ? now : 1;
  }
  bool pressed = false;
  if (button_armed && button_low_since && now - button_low_since >= PRESS_MIN_MS) {
    pressed = true;
    button_armed = 0;                // one press per push: it must be released before the next one
    LOG("button press (state %d)", bstate);
  }
  // the interrupt only counts edges now, for the log: an edge that is not a press is noise or chatter
  uint8_t edge;
  portENTER_CRITICAL(&r_mux);
  edge = button_was_pressed;  button_was_pressed = 0;
  portEXIT_CRITICAL(&r_mux);
  if (edge && !pressed && level == HIGH) button_glitches++;
  if (button_glitches && now - button_glitch_log_ms >= 10000) {
    LOG("button: %lu short glitch(es) ignored in the last 10 s (noise or a chattering contact)", (unsigned long)button_glitches);
    button_glitches = 0;
    button_glitch_log_ms = now;
  }
  // signed: the callback may have stored a millis() a little newer than "now"
  uint32_t lock_ms = lock_seen_ms;
  // the lock is the KILLSWITCH's LOCK stream: no timer of its own, it ends when the stream stops (or FREE)
  bool held = lock_ms && (int32_t)(now - lock_ms) < LOCK_TIMEOUT_MS;
  if (wired_kill_held(now, digitalRead(WIRED_KILL_PIN))) held = true;   // OR with the wired killswitch

  // button released for at least RELEASE_MIN_MS (a button that is held down must be let go first)
  bool released = button_high_since && (now - button_high_since >= RELEASE_MIN_MS);

  switch (bstate) {
    case BS_LOCKED:
      if (!held && released) {
        // a press has to start while READY: "released" means the button is up, so none is going on
        LOG("lock ended (LOCKs stopped or FREE), button works again (lock came via:%s%s%s)",
            (lock_links & LINK_ESPNOW) ? " ESP-NOW" : "", (lock_links & LINK_433) ? " 433 MHz" : "",
            (lock_links & LINK_WIRED) ? " wired" : "");
        lock_links = 0;
        button_set_state(BS_READY);
      }
      break;
    case BS_READY:
      if (held) {
        LOG("killswitch held, button locked");
        button_set_state(BS_LOCKED);
      } else if (pressed) {
        LOG("ADHD style sending BANG");
        bang_repeats_left = BANG_REPEATS;   // sent below, a few times in a row
        bang_next_ms      = now;
        button_set_state(BS_SHOW);
      }
      break;
    case BS_SHOW:
      // the show runs on the BANGER; this is just a timer: the show, then the cooldown
      if (now - bstate_since >= WAIT_TIME_BUTTON + SHOW_COOLDOWN_MS) {
        LOG("cooldown over (%d s): fresh start", SHOW_COOLDOWN_MS / 1000);
        button_set_state(held ? BS_LOCKED : BS_READY);
      }
      break;
  }

  // Outputs
  // "BANG" goes out BANG_REPEATS times (any one copy is enough, the BANGER ignores the rest)
  if (bang_repeats_left && now >= bang_next_ms) {
    char messaggio[] = "BANG";
    esp_err_t err = esp_now_send(receiverAddress, (uint8_t *)messaggio, strlen(messaggio));
    if(err != ESP_OK){
      LOG("problem ESP-NOW send: %s", esp_err_to_name(err));
    } else {
      LOG("BANG sent! (%d left)", bang_repeats_left - 1);
    }
    bang_repeats_left--;
    bang_next_ms = now + BANG_REPEAT_GAP_MS;
  }
  if (now - last_lamp_ms >= 10) {
    last_lamp_ms = now;
    // the button still held long after its press (a stuck contact): flicker, so it can be seen; it is
    // not a press, it has to be let go before the next one counts
    bool stuck = !button_armed && button_low_since && now - button_low_since >= BUTTON_STUCK_MS;
    if (stuck != button_stuck_shown) {
      button_stuck_shown = stuck;
      if (stuck) {
        LOG("button held for %d s after its press: stuck? (it must be let go before the next press)", BUTTON_STUCK_MS / 1000);
      } else {
        LOG("button let go");
      }
    }
    uint32_t ms = now - bstate_since;
    bool show_running = bstate == BS_SHOW && ms < WAIT_TIME_BUTTON;
    if (stuck && !show_running)
      ledcWrite(LED_12V_PIN, lamp_level(BS_SHOW, ms % WAIT_TIME_BUTTON));   // the show's flicker
    else
      ledcWrite(LED_12V_PIN, lamp_level(bstate, ms));
  }
  delay(2);
}

// ---- KILLSWITCH unit -----------------------------------------------------
uint8_t     ks_stable       = HIGH;   // debounced button level (LOW = held)
uint8_t     ks_raw_last     = HIGH;
uint32_t    ks_raw_since    = 0;
uint8_t     ks_locked       = 0;      // 1 = locked mode: "LOCK" goes out until the next press (which sends "FREE")
uint32_t    ks_next_lock_ms = 0;      // when the next "LOCK" goes out (while locked)
uint8_t     ks_free_left    = 0;      // "FREE" copies still to send (after unlock)
uint32_t    ks_next_free_ms = 0;
uint32_t    ks_blink_until  = 0;      // power-up blink

static bool ks_radio_idle(){
#if USE_RF433
  return !rf433_ok || rf433.mode() != RHGenericDriver::RHModeTx;
#else
  return true;
#endif
}

// Both links. The 433 MHz packet (about 70 ms on the air) is started without waiting for it, and skipped
// when the radio is still busy with the previous one (the next LOCK follows within KILL_LOCK_PERIOD_MS).
void ks_send(const char *m) {
  esp_now_send(broadcastAddress, (const uint8_t *)m, strlen(m));
#if USE_RF433
  if(rf433_ok && ks_radio_idle())
    rf433.send((const uint8_t *)m, strlen(m));
#endif
}

void killswitch_setup(){
  esp_now_peer_info_t peerInfo = {};
  memcpy(peerInfo.peer_addr, broadcastAddress, 6);
  peerInfo.channel = 0;
  peerInfo.encrypt = false;
  esp_now_add_peer(&peerInfo);

  LOG("killswitch INPUT_PULLUP PINS: %d + BOOT %d, LED PIN: %d", KILL_BUTTON_PIN, KILL_BOOT_PIN, KILL_LED_PIN);
  pinMode(KILL_BUTTON_PIN, INPUT_PULLUP);
  pinMode(KILL_BOOT_PIN, INPUT_PULLUP);
  pinMode(KILL_LED_PIN, OUTPUT);
  digitalWrite(KILL_LED_PIN, !KILL_LED_ON);
#ifdef KILL_EXT_LED_PIN
  pinMode(KILL_EXT_LED_PIN, OUTPUT);
  digitalWrite(KILL_EXT_LED_PIN, LOW);
#endif
  ks_blink_until = millis() + KILL_BLINK_MS;   // one blink at power-up: it is alive

  // minimal 80MHz, else ESP-NOW doesnt work on esp32s3
  setup_cpu_speed(80);

#if USE_RF433
  // 433 MHz transmitter (second path for LOCK / FREE)
  rf433_ok = rf433.init();
  LOG("433 MHz transmitter %s (STX882 DATA on GPIO %d)", rf433_ok ? "ready" : "init FAILED, ESP-NOW only", RF433_TX_PIN);
#endif
#ifdef KILL_TX_POWER
  WiFi.setTxPower(KILL_TX_POWER);
#endif
  LOG("killswitch Wi-Fi TX power: %d (0.25 dBm units)", (int)WiFi.getTxPower());
}

// Locked mode: "LOCK" goes out every KILL_LOCK_PERIOD_MS until the mode is switched off, which sends "FREE".
// The mode has no timer: it ends only with a press (or a reset of this unit). If the unit stops, the LOCK
// stream stops and the BUTTON unlocks itself within LOCK_TIMEOUT_MS (a dead-man switch).
static void ks_set_locked(uint8_t on, uint32_t now){
  ks_locked = on;
  if (on) {
    ks_free_left    = 0;
    ks_next_lock_ms = now;
    LOG("KILLSWITCH locked: sending LOCK until the next press");
  } else {
    ks_free_left    = KILL_REPEATS;
    ks_next_free_ms = now;
    LOG("KILLSWITCH unlocked: sending FREE");
  }
}

void do_killswitch_loop(){
  uint32_t now = millis();

  // debounce: the level must stay the same for 30 ms.
  // The external button and the BOOT button do the same (LOW = held).
  uint8_t raw = (digitalRead(KILL_BUTTON_PIN) == LOW || digitalRead(KILL_BOOT_PIN) == LOW) ? LOW : HIGH;
  if (raw != ks_raw_last) {
    ks_raw_last  = raw;
    ks_raw_since = now;
  }
  if (raw != ks_stable && now - ks_raw_since >= 30) {
    ks_stable = raw;
    // a press (the hold starts) toggles the mode; the release does nothing
    if (ks_stable == LOW) ks_set_locked(!ks_locked, now);
  }

  if (ks_locked && (int32_t)(now - ks_next_lock_ms) >= 0) {
    ks_send("LOCK");
    ks_next_lock_ms = now + KILL_LOCK_PERIOD_MS;
  }
  // FREE goes out when the 433 MHz radio is idle: a LOCK still on the air would arrive after the ESP-NOW
  // FREE and lock the button again for a moment
  if (ks_free_left && (int32_t)(now - ks_next_free_ms) >= 0 && ks_radio_idle()) {
    ks_send("FREE");
    ks_free_left--;
    ks_next_free_ms = now + KILL_FREE_GAP_MS;
  }

  // LED: on while locked, plus the power-up blink
  uint8_t on = ks_locked || (int32_t)(ks_blink_until - now) > 0;
  digitalWrite(KILL_LED_PIN, on ? KILL_LED_ON : !KILL_LED_ON);
#ifdef KILL_EXT_LED_PIN
  digitalWrite(KILL_EXT_LED_PIN, on ? HIGH : LOW);
#endif
  delay(2);
}
// ==== BUTTON / KILLSWITCH END ====

#ifdef HAS_DFPLAYER
// DFPlayer on the DFPLAYER_* pins, sets sound_ok. Shared by the BANGER (with BANGER_DFPLAYER) and the EXPLOSION box.
// UART to the DFPlayer (BANGER and EXPLOSION box)
void dfplayer_uart_setup(){
  LOG("DFPlayer UART setup: 9600, %d, %d, %d", SERIAL_8N1, DFPLAYER_RX_PIN, DFPLAYER_TX_PIN);
  DFPLayerSerial.begin(9600, SERIAL_8N1, DFPLAYER_RX_PIN, DFPLAYER_TX_PIN);
  // pull-up: an unconnected BUSY wire reads HIGH = "not playing"
  pinMode(DFPLAYER_BUSY_PIN, INPUT_PULLUP);
}

// Is a DFPlayer there? A raw "query status" (0x42) goes out and its answer (7E FF 06 42 ...) is looked for,
// with no library call in between. The library's ACK wait spins forever when noise on the RX line keeps
// "available" true and no DFPlayer ever clears _isSending (seen on an EXPLOSION box with no DFPlayer:
// the box hung in the search and the watchdog rebooted it), so the library never waits for an ACK here.
uint8_t dfplayer_answers(){
  static const uint8_t query[10] = {0x7E, 0xFF, 0x06, 0x42, 0x00, 0x00, 0x00, 0xFE, 0xB9, 0xEF};
  while(DFPLayerSerial.available())
    DFPLayerSerial.read();
  DFPLayerSerial.write(query, sizeof(query));
  uint8_t win[4] = {0, 0, 0, 0};           // the last 4 bytes received
  uint32_t t0 = millis();
  while(millis() - t0 < DFPLAYER_BUSY_TIMEOUT_MS){
    doYIELD;
    while(DFPLayerSerial.available()){
      memmove(win, win + 1, 3);
      win[3] = DFPLayerSerial.read();
      if(win[0] == 0x7E && win[1] == 0xFF && win[2] == 0x06 && win[3] == 0x42)
        return 1;
    }
    delay(1);
  }
  return 0;
}

// One try: the DFPlayer answers, BUSY works, settings applied. Blocks for about DFPLAYER_BUSY_TIMEOUT_MS at most
uint8_t dfplayer_try_init(){
  if(!dfplayer_answers())
    return 0;
  // ACK mode stays off from here on (public way: begin() with isACK false, no reset, no waiting): every
  // command is sent without waiting for an answer, so nothing can block
  myDFPlayer.begin(DFPLayerSerial, false, false);
  LOG("DFPlayer Mini ready! Will check BUSY pin number: %u", DFPLAYER_BUSY_PIN);
  uint32_t t0 = millis();
  while(digitalRead(DFPLAYER_BUSY_PIN) == LOW){
    if(millis() - t0 >= DFPLAYER_BUSY_TIMEOUT_MS){
      LOG("DFPlayer BUSY pin stuck LOW");
      return 0;
    }
    doYIELD;
    delay(100);
  }
  LOG("DFPlayer BUSY HIGH, continue");
  myDFPlayer.volume(SOUND_VOLUME);
  myDFPlayer.EQ(DFPLAYER_EQ_ROCK);
  myDFPlayer.outputDevice(DFPLAYER_DEVICE_SD);
  myDFPlayer.enableDAC();
  LOG("DFPlayer setup complete");
  return 1;
}

#if defined(BANGER) && defined(BANGER_DFPLAYER)
// BANGER: a few tries at boot, then the show runs without sound
void sound_setup(){
  doYIELD;
  LOG("DFPlayer Mini WAIT 1");
  delay(3000);
  dfplayer_uart_setup();
  LOG("DFPlayer Mini WAIT 2");
  delay(3000);

  LOG("DFPlayer Mini setup START");
  uint8_t ok = 0;
  for(uint8_t i = 0; i < DFPLAYER_INIT_TRIES && !ok; i++){
    doYIELD;
    ok = dfplayer_try_init();
    if(!ok){
      LOG("DFPlayer Mini not detected (try %d/%d)", i + 1, DFPLAYER_INIT_TRIES);
      delay(500);
    }
  }
  sound_ok = ok;
  if(!sound_ok){
    LOG("DFPlayer not working: light show only, no sound");
    return;
  }
}
#endif
#endif

// ESP-NOW peer (unicast target, no encryption)
static void add_peer(const uint8_t *mac){
  esp_now_peer_info_t peerInfo = {};
  memcpy(peerInfo.peer_addr, mac, 6);
  peerInfo.channel = 0;
  peerInfo.encrypt = false;
  esp_now_add_peer(&peerInfo);
}

void banger_setup(){
  // first, so a BANG is never missed whatever happens with the DFPlayer below
  esp_now_register_recv_cb(OnDataRecv);

  // Fancy led strip
  setup_led_strip();

  // status LED (WS2812 on the S3 Zero), updated from myYIELD()
  pinMode(BUILTIN_LED, OUTPUT);
  digitalWrite(BUILTIN_LED, LOW);

#ifdef EXPLOSION_MACS
  for(uint8_t i = 0; i < EXPLOSION_COUNT; i++)
    add_peer(explosionAddress[i]);
  LOG("EXPLOSION boxes: %d, their sounds are announced to them", EXPLOSION_COUNT);
#endif
#ifdef STROBO_MACS
  for(uint8_t i = 0; i < STROBO_COUNT; i++)
    add_peer(stroboAddress[i]);
  LOG("STROBO boxes: %d, the KABOOM strobe is announced to them", STROBO_COUNT);
#endif

#ifdef BANGER_DFPLAYER
  sound_setup();
#endif
}

#ifdef EXPLOSION
uint32_t expl_next_try_ms = 0;      // EXPLOSION: when the next DFPlayer search starts
uint32_t expl_play_ms     = 0;      // EXPLOSION: when the last sound was started (0 = none yet)

void explosion_setup(){
  // first, so a SND is never missed whatever happens with the DFPlayer below
  esp_now_register_recv_cb(OnDataRecv);
#ifdef EXPL_LED_PIN
  pinMode(EXPL_LED_PIN, OUTPUT);
  digitalWrite(EXPL_LED_PIN, !EXPL_LED_ON);
#endif
  dfplayer_uart_setup();
  // no search here: do_explosion_loop() searches, so the watchdog is fed between the tries
  sound_ok = 0;
  // allow for DFPlayer to boot up, as explosion_setup() doesnt do the setup anymore and loop immediately loops
  delay(3000);
}

// EXPLOSION box: plays the sound the BANGER announces. A repeated SND (the BANGER sends
// each one once, the Wi-Fi retries it) is ignored for SND_DEDUPE_MS after it played.
#define SND_DEDUPE_MS 1000
uint32_t snd_last_ms[3] = {0, 0, 0};

void do_explosion_loop(){
  uint32_t now = millis();
  // find the DFPlayer: first search at once, then every EXPL_RETRY_MS for as long as it is missing
  if(!sound_ok && (int32_t)(now - expl_next_try_ms) >= 0){
    expl_next_try_ms = now + EXPL_RETRY_MS;   // set first: a slow try does not shorten the wait
    LOG("DFPlayer search");
    sound_ok = dfplayer_try_init();
    if(sound_ok){
      LOG("DFPlayer found: sound on");
    } else {
      LOG("DFPlayer not found, next search in %d s", EXPL_RETRY_MS / 1000);
    }
  }
#ifdef EXPL_LED_PIN
  // LED: blinking while the DFPlayer is missing, flickering while a sound plays, lit when ready
  uint8_t led_on;
  if(!sound_ok){
    led_on = (now / EXPL_BLINK_MS) & 1;
  } else if(sound_is_playing() || (expl_play_ms && now - expl_play_ms < EXPL_PLAY_GRACE_MS)){
    led_on = (((now / EXPL_FLICKER_MS) * 2654435761u) >> 24) & 1;   // a new random bit every step
  } else {
    led_on = 1;
  }
  digitalWrite(EXPL_LED_PIN, led_on ? EXPL_LED_ON : !EXPL_LED_ON);
#endif
  if(snd_req){
    uint8_t n = snd_req;
    snd_req = 0;
    LOG("SND%d received ms=%lu", (int)n, (unsigned long)now);
    if(!snd_last_ms[n] || now - snd_last_ms[n] >= SND_DEDUPE_MS){
      snd_last_ms[n] = now ? now : 1;
      expl_play_ms   = snd_last_ms[n];
      play_sound(n);
    } else {
      LOG("SND%d ignored (repeat)", (int)n);
    }
  }
  delay(2);
}
#endif   // EXPLOSION

void setup() {
#if LOG_USB_HWCDC
  Serial.setTxBufferSize(LOG_TX_BUFFER);  // room for the boot burst of log lines
#endif
  UART0.begin(115200);
#if LOG_USB_HWCDC
  Serial.setTxTimeoutMs(0);               // never wait for the PC to read (see LOGPRINT)
#endif

  setup_wdt();

  // builtin LED: see banger_led_update() (bit-banged, neopixelWrite() fails because the strip uses RMT)

  // only the BANGER has a strip (GPIO 4 is a free pin on the others)
  if (WHAT == IS_BANGER && !rmtInit(LED_STRIP_GPIO_PIN, RMT_TX_MODE, RMT_MEM_NUM_BLOCKS_1, 10000000)) {
    LOG("init sender failed");
  }

  // enable WiFi-now
  WiFi.mode(WIFI_STA);
  WiFi.setSleep(false);
  if (esp_now_init() != ESP_OK) {
    LOG("Error initializing ESP-NOW");
    return;
  }
  if(WHAT == IS_BANGER){
     banger_setup();
  }
  if(WHAT == IS_BUTTON){
     button_setup();
  }
  if(WHAT == IS_KILLSWITCH){
     killswitch_setup();
  }
#ifdef EXPLOSION
  if(WHAT == IS_EXPLOSION){
     explosion_setup();
  }
#endif
  if(WHAT == IS_STROBO){
     strobo_setup();
  }
}

uint8_t  cooling_logged = 0;        // BANGER: a cooldown is running (logged when it ends)

void do_banger_loop(){
  // BANGER just logs some info, the OnDataRecv handles the real thing
  // cooldown after a show: every BANG is dropped, then a fresh start
  bool cooling = banger_cooling();
  if(cooling_logged && !cooling){
    cooling_logged = 0;
    trigger_animation = 0;
    LOG("cooldown over: ready for a new show");
  }
  if(trigger_animation == 1){
    trigger_animation = 0;
    LOG("received DEMOLITION request! from %02x:%02x:%02x:%02x:%02x:%02x (BANG #%lu)",
        bang_src[0], bang_src[1], bang_src[2], bang_src[3], bang_src[4], bang_src[5], (unsigned long)bang_rx);
    if(cooling){
      LOG("BANG ignored: cooldown, %lu s left", (unsigned long)((SHOW_COOLDOWN_MS - (millis() - show_end_ms)) / 1000));
    } else if(!animation_is_playing()){
      printed_ready = 0;
      play_something();
      // copies of the same BANG (and any early press) that arrived during the show are dropped
      trigger_animation = 0;
      show_end_ms = millis() ? millis() : 1;
      cooling_logged = 1;
      LOG("cooldown: %d s, BANGs are dropped until then", SHOW_COOLDOWN_MS / 1000);
    } else {
      LOG("animation already running");
    }
  }
  if(animation_is_playing()){
    if(millis() - last_activity > 100){
      last_activity = millis();
      LOG("show is running");
    }
  } else {
    if(!printed_ready){
      printed_ready = 1;
      LOG("READY TO DEMOLISH");
    }
  }
}

// ==== TEST SERIAL BEGIN ====
// Test build only (-DTEST_SERIAL, with --log): one command per line on the USB serial, for the bench
// test (tools/bench/run_tests.py). status | fire | lock | free, BUTTON also hold | chatter | release | glitch.
// Never in a production build.
#ifdef TEST_SERIAL
static const char *test_role_name(){
#if defined(BANGER)
  return "BANGER";
#elif defined(BUTTON)
  return "BUTTON";
#elif defined(KILLSWITCH)
  return "KILLSWITCH";
#elif defined(EXPLOSION)
  return "EXPLOSION";
#else
  return "STROBO";
#endif
}

// why the chip last started: "poweron", "brownout", "panic", "wdt" ... (esp_reset_reason_t)
static const char *test_reset_name(){
  switch(esp_reset_reason()){
    case ESP_RST_POWERON:   return "poweron";
    case ESP_RST_SW:        return "sw";
    case ESP_RST_PANIC:     return "panic";
    case ESP_RST_INT_WDT:
    case ESP_RST_TASK_WDT:
    case ESP_RST_WDT:       return "wdt";
    case ESP_RST_BROWNOUT:  return "brownout";
    case ESP_RST_USB:       return "usb";
    case ESP_RST_PWR_GLITCH:return "glitch";
    default:                return "other";
  }
}

static void test_command(const char *cmd){
  if(!strcmp(cmd, "status")){
    LOG("TEST status role=%s reset=%s heap=%lu wait=%d cooldown=%d ms=%lu", test_role_name(), test_reset_name(),
        (unsigned long)ESP.getFreeHeap(), WAIT_TIME_BUTTON, SHOW_COOLDOWN_MS, (unsigned long)millis());
  } else if(!strcmp(cmd, "fire")){
    LOG("TEST fire ms=%lu", (unsigned long)millis());
#ifdef BUTTON
    test_press_until = millis() + 100;   // a clean 100 ms press, through the same filter as the real button
    if (!test_press_until) test_press_until = 1;
#endif
#ifdef BANGER
    trigger_animation = 1;           // the same as a received "BANG"
#endif
#ifdef BUTTON
  } else if(!strcmp(cmd, "hold")){       // the button stuck down
    test_pin_mode = 1;
    LOG("TEST hold ms=%lu", (unsigned long)millis());
  } else if(!strcmp(cmd, "chatter")){    // a chattering contact: 5 ms LOW / 5 ms HIGH
    test_pin_mode = 2;
    LOG("TEST chatter ms=%lu", (unsigned long)millis());
  } else if(!strcmp(cmd, "release")){    // back to the real pin
    test_pin_mode = 0;
    LOG("TEST release ms=%lu", (unsigned long)millis());
  } else if(!strcmp(cmd, "glitch")){     // an interrupt edge with the pin HIGH again: noise
    portENTER_CRITICAL(&r_mux);
    button_was_pressed = 1;
    portEXIT_CRITICAL(&r_mux);
    LOG("TEST glitch ms=%lu", (unsigned long)millis());
#endif
  } else if(!strcmp(cmd, "lock")){
#ifdef KILLSWITCH
    LOG("TEST lock ms=%lu", (unsigned long)millis());
    if(!ks_locked) ks_set_locked(1, millis());     // the same as a press that locks
#endif
  } else if(!strcmp(cmd, "free")){
#ifdef KILLSWITCH
    LOG("TEST free ms=%lu", (unsigned long)millis());
    if(ks_locked) ks_set_locked(0, millis());      // the same as a press that unlocks
#endif
  } else {
    LOG("TEST unknown command: %s", cmd);
  }
}

static void test_poll(){
  static char line[24];
  static uint8_t n = 0;
  while(Serial.available()){
    char c = Serial.read();
    if(c == '\r') continue;
    if(c != '\n'){
      if(n < sizeof(line) - 1) line[n++] = c;
      continue;
    }
    line[n] = 0;
    n = 0;
    test_command(line);
  }
}
#endif
// ==== TEST SERIAL END ====

void loop() {
  wdt_feed();
#ifdef TEST_SERIAL
  test_poll();
#endif
  doYIELD;
  if(WHAT == IS_BANGER){
      do_banger_loop();
  }
  if(WHAT == IS_BUTTON){
      do_button_loop();
  }
  if(WHAT == IS_KILLSWITCH){
      do_killswitch_loop();
  }
#ifdef EXPLOSION
  if(WHAT == IS_EXPLOSION){
      do_explosion_loop();
  }
#endif
  if(WHAT == IS_STROBO){
      do_strobo_loop();
  }
}

uint8_t animation_is_playing() {
  if(animation_is_running)
    return 1;
  return sound_is_playing();
}

uint8_t sound_is_playing(){
#ifdef HAS_DFPLAYER
  if(!sound_ok)
    return 0;
  int busyState = digitalRead(DFPLAYER_BUSY_PIN);
  if(busyState == LOW)
    return 1;
#endif
  return 0;
}

// wait for the sound to end, but never longer than SOUND_END_TIMEOUT_MS: a BUSY pin that
// stays LOW means the DFPlayer is broken, so the next shows run without sound
void wait_sound_end(uint8_t n){
  uint32_t t0 = millis();
  while(sound_is_playing()){
    if(millis() - t0 >= SOUND_END_TIMEOUT_MS){
      LOG("sound %d did not end (BUSY stuck LOW?): light show only from now on", n);
      sound_ok = 0;
      break;
    }
    doYIELD;
    delay(1);
  }
}

void play_sound(uint8_t n){
#ifdef HAS_DFPLAYER
  if(!sound_ok){
    LOG("no DFPlayer, skipping File: %d", n);
    return;
  }
  myDFPlayer.volume(SOUND_VOLUME); // Volume 0-30
  LOG("Playing File: %d", n);
  myDFPlayer.play(n);
#endif
}

// tell the EXPLOSION box (if this build has one) that a sound starts now. Sent whether or not
// the DFPlayer here works. The box is never waited for; check on the bench that a missing box
// does not delay the show (esp_now_send to an absent peer may take time while Wi-Fi retries)
void send_snd(uint8_t n){
#ifdef EXPLOSION_MACS
  const char *m = (n == SOUND_1) ? "SND1" : "SND2";
  for(uint8_t i = 0; i < EXPLOSION_COUNT; i++){
    esp_err_t err = esp_now_send(explosionAddress[i], (const uint8_t *)m, 4);
    if(err != ESP_OK) LOG("%s to box %d: %s", m, i, esp_err_to_name(err));
  }
  LOG("%s sent to %d box(es) ms=%lu", m, EXPLOSION_COUNT, (unsigned long)millis());
#endif
}

// tell the STROBO boxes (if this build has any) that the KABOOM animation starts now; same
// best-effort rules as send_snd()
void send_strb(){
#ifdef STROBO_MACS
  for(uint8_t i = 0; i < STROBO_COUNT; i++){
    esp_err_t err = esp_now_send(stroboAddress[i], (const uint8_t *)"STRB", 4);
    if(err != ESP_OK) LOG("STRB to box %d: %s", i, esp_err_to_name(err));
  }
  LOG("STRB sent to %d box(es) ms=%lu", STROBO_COUNT, (unsigned long)millis());
#endif
}

void play_something() {
  animation_is_running = 1;
  last_activity = millis();
  uint32_t show_t0 = last_activity;
  LOG("SHOW start ms=%lu", (unsigned long)show_t0);

  // sound effect 1 (Whooosh)
  send_snd(SOUND_1);
  play_sound(SOUND_1);

  // ledstrip clear, +1
  run_ledstrip_animation_1();
  wait_sound_end(SOUND_1);

  // sound effect (Kabooom)
#ifdef HAS_DFPLAYER
  if(sound_ok)
    myDFPlayer.stop();
#endif
  send_snd(SOUND_2);
  play_sound(SOUND_2);

  // ledstrip +2, clear
  send_strb();
  run_ledstrip_animation_2();
  wait_sound_end(SOUND_2);

  // done
  LOG("SHOW done ms=%lu duration=%lu heap=%lu bang_rx=%lu", (unsigned long)millis(), (unsigned long)(millis() - show_t0),
      (unsigned long)ESP.getFreeHeap(), (unsigned long)bang_rx);
  LOG("done showing demolition animation");
  animation_is_running = 0;
  trigger_animation = 0;
  printed_ready = 0;
}

void setup_led_strip(){
  strip.begin();           // Claims the RMT channel safely under Core 3.x
  strip.setBrightness(10); // Keep current draw safe
  strip.clear();
  strip.show();
}

// ==== ANIMATIONS BEGIN ====
// -------------------------------------------------------------------------
//  TUNING - change these to taste
// -------------------------------------------------------------------------
#define FUSE_LEN          (LINE_END - LINE_START + 1)   // 420 LEDs
#define RING_LEN          (RING_END - RING_START + 1)   // 180 LEDs
// The animation was designed on a 120-LED fuse. The times stay the same (the sound does not change), so on a
// longer fuse the spark, the shockwave and the ghost wisp run faster; trail and spark spread grow with it.
#define FUSE_SCALE        (FUSE_LEN / 120.0f)
#define FUSE_TAIL         ((int)(14 * FUSE_SCALE))   // length of the glowing trail behind the spark (LEDs)

#define FUSE_BURN_MS      6000    // time for the spark to run the fuse (match SOUND_1 length)
#define FAKEOUT_ENABLED   1       // 1 = spark stalls, nearly dies, re-ignites with a flare
#define FAKEOUT_AT_PCT    55      // where it stalls (% of the way along the fuse)
#define FAKEOUT_MS        1000    // how long the stall lasts

#define RING_IGNITE_MS    1800    // fire spreads both ways around the ring
#define BUILDUP_MIN_MS    2000    // minimum "about to blow" time (also waits for SOUND_1 to end)
#define BUILDUP_MAX_MS    15000   // safety: never wait longer than this for the sound

#define KABOOM_FLASH_MS   180     // white flash (vampire disappears here!)
#define KABOOM_FIRE_MS    600     // flash + fireball fade
#define KABOOM_TOTAL_MS   3800    // whole KABOOM animation incl. embers + purple ghost wisp

// -------------------------------------------------------------------------
//  Helpers
// -------------------------------------------------------------------------
float clampf(float x, float lo, float hi) { return x < lo ? lo : (x > hi ? hi : x); }
float rnd01() { return random(0, 1000) / 1000.0f; }

uint32_t rgbf(float r, float g, float b) {
  return strip.Color((uint8_t)clampf(r, 0, 255), (uint8_t)clampf(g, 0, 255), (uint8_t)clampf(b, 0, 255));
}

// Black-body style fire palette: 0 = black, 0.33 = red, 0.66 = orange/yellow, 1 = white
uint32_t fireColor(float h) {
  h = clampf(h, 0.0f, 1.0f) * 3.0f;
  return rgbf(h * 255.0f, (h - 1.0f) * 255.0f, (h - 2.0f) * 255.0f);
}

// Moment (ms since start) the spark reaches the end of the fuse
float fuse_cross_ms() {
  float te = powf((float)FUSE_LEN / (FUSE_LEN + FUSE_TAIL), 1.0f / 1.25f) * FUSE_BURN_MS;
#if FAKEOUT_ENABLED
  float stallT = powf(FAKEOUT_AT_PCT / 100.0f, 1.0f / 1.25f) * FUSE_BURN_MS;
  if (te >= stallT) te += FAKEOUT_MS;
#endif
  return te;
}

// Spark position in LEDs (can be > FUSE_LEN so the tail runs off the end).
// The spark accelerates along the fuse. stallFrac >= 0 while stalled (0..1), flare = just re-ignited.
float fuse_head_pos(uint32_t ms, float *stallFrac, bool *flare) {
  float te = (float)ms;
  *stallFrac = -1.0f;
  *flare = false;
#if FAKEOUT_ENABLED
  float stallT = powf(FAKEOUT_AT_PCT / 100.0f, 1.0f / 1.25f) * FUSE_BURN_MS;
  if (ms >= stallT) {
    if (ms < stallT + FAKEOUT_MS) {
      te = stallT;
      *stallFrac = (ms - stallT) / (float)FAKEOUT_MS;
    } else {
      te = ms - FAKEOUT_MS;
      if (ms < stallT + FAKEOUT_MS + 350) *flare = true;
    }
  }
#endif
  return powf(clampf(te / FUSE_BURN_MS, 0.0f, 1.0f), 1.25f) * (FUSE_LEN + FUSE_TAIL);
}

// -------------------------------------------------------------------------
//  Fuse: brown twisted rope, white-hot spark, fiery trail, burnt = dark
// -------------------------------------------------------------------------
void draw_fuse(uint32_t ms) {
  float stallFrac; bool flare;
  float head = fuse_head_pos(ms, &stallFrac, &flare);
  int tail = flare ? FUSE_TAIL * 2 : FUSE_TAIL;

  float k = 1.0f;                                   // spark brightness (dies during the fake-out)
  if (stallFrac >= 0.0f)
    k = clampf(1.0f - stallFrac * 1.4f, 0.0f, 1.0f) * (0.4f + 0.6f * rnd01());

  for (int i = 0; i < FUSE_LEN; i++) {
    float d = head - i;
    uint32_t c = 0;
    if (d < 0) {
      c = ((i / 2) % 2) ? rgbf(95, 45, 6) : rgbf(55, 22, 2);      // unburnt rope (twist pattern)
    } else if (d < tail) {
      float h = (1.0f - d / tail) * 0.85f + rnd01() * 0.15f;
      c = fireColor(h * k);
      if (d < 1.5f) c = flare ? rgbf(255, 255, 255) : rgbf(255 * k, 200 * k, 90 * k);
    }
    strip.setPixelColor(LINE_START + i, c);
  }

  // crackling sparks around the head
  if (stallFrac < 0.0f) {
    for (int s = 0; s < 3; s++) {
      int spread = (int)(6 * FUSE_SCALE);
      int idx = (int)head + random(-spread, spread + 1);
      if (idx >= 0 && idx < FUSE_LEN) strip.setPixelColor(LINE_START + idx, rgbf(255, 220, 100));
    }
  } else if (stallFrac > 0.7f && random(8) == 0) {   // last dying ember
    int idx = (int)head;
    if (idx >= 0 && idx < FUSE_LEN) strip.setPixelColor(LINE_START + idx, rgbf(120, 10, 0));
  }
}

// -------------------------------------------------------------------------
//  Ring: dark dynamite until the spark arrives, then fire spreads both ways,
//  flickers faster and whiter ("build-up") until KABOOM
// -------------------------------------------------------------------------
void draw_ring(uint32_t ms, float ringStartMs) {
  if (ms < ringStartMs) {
    for (int j = 0; j < RING_LEN; j++) strip.setPixelColor(RING_START + j, rgbf(60, 5, 0));
    return;
  }
  float rt     = ms - ringStartMs;
  float spread = clampf(rt / RING_IGNITE_MS, 0.0f, 1.0f) * (RING_LEN / 2.0f);
  float build  = clampf((rt - RING_IGNITE_MS) / (float)BUILDUP_MIN_MS, 0.0f, 1.0f);
  float speed  = 0.010f * (1.0f + build * 2.5f);

  for (int j = 0; j < RING_LEN; j++) {
    int d = (j < RING_LEN - j) ? j : (RING_LEN - j);   // distance from where the fuse enters
    uint32_t c;
    if (d <= spread) {
      float h = (0.65f + 0.15f * build) * (0.45f + 0.55f * rnd01())
              + 0.20f * sinf(j * 0.8f - ms * speed)
              + 0.45f * build * build;
      c = fireColor(h);
      if (rt < RING_IGNITE_MS && d > spread - 2) c = rgbf(255, 240, 200);   // white-hot leading edge
    } else {
      c = rgbf(60, 5, 0);
    }
    strip.setPixelColor(RING_START + j, c);
  }
}

// -------------------------------------------------------------------------
//  Animation 1 (during SOUND_1): fuse burns -> ring ignites -> build-up.
//  Does NOT clear at the end: the ring keeps glowing white-hot until KABOOM.
// -------------------------------------------------------------------------
void run_ledstrip_animation_1() {
  LOG("RUNNING Animation LED 1: fuse + ring ignition");
  float ringStart = fuse_cross_ms();
  uint32_t buildDone = (uint32_t)(ringStart + RING_IGNITE_MS + BUILDUP_MIN_MS);
  uint32_t t0 = millis();
  uint32_t frames = 0, last_frame = t0, max_gap = 0;   // max_gap: the longest stall between two frames

  for (;;) {
    doYIELD;
    frames++;
    uint32_t now_f = millis();
    if (now_f - last_frame > max_gap) max_gap = now_f - last_frame;
    last_frame = now_f;
    uint32_t ms = millis() - t0;
    strip.clear();
    draw_fuse(ms);
    draw_ring(ms, ringStart);
    strip.show();

    if (ms >= buildDone && !sound_is_playing()) break;
    if (ms >= buildDone + BUILDUP_MAX_MS) {           // safety net: BUSY stuck LOW, stop trusting it
      LOG("sound 1 did not end: light show only from now on");
      sound_ok = 0;
      break;
    }
    delay(2);
  }
  LOG("RUNNING Animation LED 1: DONE frames=%lu max_gap=%lu", (unsigned long)frames, (unsigned long)max_gap);
}

// -------------------------------------------------------------------------
//  Animation 2 (during SOUND_2): KABOOM flash + shockwave down the fuse,
//  fading fireball, dying embers, purple ghost wisp drifting back along the fuse.
// -------------------------------------------------------------------------

// ---- STROBO box ----------------------------------------------------------------------------
// Fires a short BURST of flashes when the BANGER sends "STRB" (the moment its animation 2 starts).
// The flashes are PWM on the MOSFET gate, so STROBO_BRIGHTNESS dims them. Everything is bounded:
// STROBO_FLASHES flashes of STROBO_ON_MS with STROBO_OFF_MS dark between them, a hard stop after
// STROBO_MAX_BURST_MS whatever the timing says, and a new STRB within STRB_MIN_GAP_MS of the last
// burst is ignored, so repeats or a glitch cannot re-fire it. The pin is forced LOW between and after
// the flashes. The COB chips are on for STROBO_FLASHES * STROBO_ON_MS only (480 ms at the defaults).
#define STRB_MIN_GAP_MS     5000    // must stay longer than STROBO_MAX_BURST_MS (checked below)
#define STROBO_FLASHES      6       // flashes in one burst
#define STROBO_ON_MS        80      // length of one flash
#define STROBO_OFF_MS       120     // dark between two flashes
#define STROBO_MAX_BURST_MS 2000    // hard stop for the whole burst
#define STROBO_BRIGHTNESS   255     // 0-255 PWM duty of each flash: 255 = full, lower = dimmer
#define STROBO_PWM_HZ      5000     // PWM frequency (well above flicker); STROBO_BRIGHTNESS only scales the level
#if STRB_MIN_GAP_MS <= STROBO_MAX_BURST_MS
#error "STRB_MIN_GAP_MS must be longer than STROBO_MAX_BURST_MS, or a burst can be re-fired while it runs"
#endif
uint32_t strobo_burst_t0 = 0;       // millis() when the running burst started (0 = idle)
uint32_t strobo_phase_ms = 0;       // millis() when the current flash or dark gap started
uint8_t  strobo_fired    = 0;       // flashes started in the running burst
uint8_t  strobo_on       = 0;       // 1 = a flash is on now
uint32_t strobo_last_ms  = 0;       // when the last burst started (0 = none yet)

void strobo_setup(){
  esp_now_register_recv_cb(OnDataRecv);
  // flash off from the start: PWM duty 0 (the pull-down keeps the pin low while the ESP32 boots)
  ledcAttach(STROBE_PIN, STROBO_PWM_HZ, 8);
  ledcWrite(STROBE_PIN, 0);
#ifdef EXPL_LED_PIN
  pinMode(EXPL_LED_PIN, OUTPUT);
  digitalWrite(EXPL_LED_PIN, EXPL_LED_ON);     // lit: ready
#endif
  LOG("STROBO ready, strobe pin %d", (int)STROBE_PIN);
}

static void strobo_set(uint8_t on){
  strobo_on = on;
  ledcWrite(STROBE_PIN, on ? STROBO_BRIGHTNESS : 0);
}

void do_strobo_loop(){
  uint32_t now = millis();
  if(strb_req){
    strb_req = 0;
    LOG("STRB received ms=%lu", (unsigned long)now);
    if(!strobo_burst_t0 && (!strobo_last_ms || now - strobo_last_ms >= STRB_MIN_GAP_MS)){
      strobo_burst_t0 = strobo_last_ms = now ? now : 1;
      strobo_phase_ms = now;
      strobo_fired = 1;
      strobo_set(1);
      LOG("STRB: flash on ms=%lu (burst of %d)", (unsigned long)now, STROBO_FLASHES);
    } else {
      LOG("STRB ignored (burst running or within %d s)", STRB_MIN_GAP_MS / 1000);
    }
  }
  if(strobo_burst_t0){
    bool stop = now - strobo_burst_t0 >= STROBO_MAX_BURST_MS;
    if(!stop){
      if(strobo_on && now - strobo_phase_ms >= STROBO_ON_MS){
        strobo_set(0);
        strobo_phase_ms = now;
        if(strobo_fired >= STROBO_FLASHES) stop = true;
      } else if(!strobo_on && now - strobo_phase_ms >= STROBO_OFF_MS){
        strobo_set(1);
        strobo_phase_ms = now;
        strobo_fired++;
      }
    }
    if(stop){
      strobo_set(0);
      strobo_burst_t0 = 0;
      LOG("STRB: flash off ms=%lu (%d flashes)", (unsigned long)now, strobo_fired);
    }
  }
#ifdef EXPL_LED_PIN
  // LED: lit when ready, dark for the whole burst. The 12 V strobe LEDs need the 12 V brick, so on USB-C
  // power alone this blink is the only sign that the burst fired
  uint8_t led_on = strobo_burst_t0 ? 0 : 1;
  digitalWrite(EXPL_LED_PIN, led_on ? EXPL_LED_ON : !EXPL_LED_ON);
#endif
  delay(1);
}

void run_ledstrip_animation_2() {
  LOG("RUNNING Animation LED 2: KABOOM");
  uint32_t t0 = millis();
  uint32_t frames = 0, last_frame = t0, max_gap = 0;

  for (;;) {
    doYIELD;
    frames++;
    uint32_t now_f = millis();
    if (now_f - last_frame > max_gap) max_gap = now_f - last_frame;
    last_frame = now_f;
    uint32_t ms = millis() - t0;
    if (ms >= KABOOM_TOTAL_MS) break;
    strip.clear();

    if (ms < KABOOM_FIRE_MS) {
      // ring: white flash that cools to orange/red
      float cool = (ms < KABOOM_FLASH_MS) ? 1.0f
                 : 1.0f - (ms - KABOOM_FLASH_MS) / (float)(KABOOM_FIRE_MS - KABOOM_FLASH_MS);
      for (int j = 0; j < RING_LEN; j++) {
        float h = (ms < KABOOM_FLASH_MS) ? 1.0f : (0.15f + 0.85f * cool) * (0.4f + 0.6f * rnd01());
        strip.setPixelColor(RING_START + j, fireColor(h));
      }
      // shockwave racing back down the fuse
      float front = ms * 1.2f * FUSE_SCALE;              // LEDs per ms: down the whole fuse in ~100 ms
      float width = 25 * FUSE_SCALE;
      for (int i = 0; i < FUSE_LEN; i++) {
        float dist = (FUSE_LEN - 1 - i);
        if (dist < front && dist > front - width) {
          float b = 1.0f - (front - dist) / width;
          strip.setPixelColor(LINE_START + i, rgbf(255 * b, 220 * b, 160 * b));
        }
      }
    } else {
      float tC = ms - KABOOM_FIRE_MS;
      float fade = 1.0f - tC / (float)(KABOOM_TOTAL_MS - KABOOM_FIRE_MS);

      // dying embers on the ring
      for (int j = 0; j < RING_LEN; j++) {
        if (random(100) < (int)(4 + 22 * fade)) {
          float e = (0.3f + 0.7f * rnd01()) * fade;
          strip.setPixelColor(RING_START + j, rgbf(255 * e, 40 * e, 0));
        }
      }
      // purple ghost wisp drifting away from the ring along the fuse
      float front = tC * 0.06f * FUSE_SCALE;             // LEDs per ms: reaches the start in ~2 s
      for (int i = 0; i < FUSE_LEN; i++) {
        float dist = (FUSE_LEN - 1 - i);
        if (dist < front) {
          float w = (0.5f + 0.5f * sinf(dist * 0.09f - tC * 0.006f)) * fade;
          strip.setPixelColor(LINE_START + i, rgbf(110 * w, 10 * w, 220 * w));
        }
      }
    }
    strip.show();
    delay(2);
  }

  strip.clear();
  strip.show();
  LOG("RUNNING Animation LED 2: DONE frames=%lu max_gap=%lu", (unsigned long)frames, (unsigned long)max_gap);
}
// ==== ANIMATIONS END ====

void setup_wdt(){
  esp_err_t ok;

  // First, deinitialize the Arduino core's WDT if it exists
  esp_task_wdt_deinit();

  // Now initialize with our custom config
  esp_task_wdt_config_t wdt_config = {
    .timeout_ms = WATCHDOG_TIMEOUT_MS,
    .idle_core_mask = 0,
    .trigger_panic = true,   // after the handler below returns, the IDF panics: backtrace of the stuck code, then reboot
  };
  ok = esp_task_wdt_init(&wdt_config);
  if(ok != ESP_OK) {
    LOG("Failed to initialize task watchdog: %s", esp_err_to_name(ok));
    return;
  }
  LOG("[WDT] Task watchdog initialized");

  // Register watchdog timeout callback
  ok = esp_task_wdt_add_user((char*)"main", &wdt_user_handle);
  if(ok != ESP_OK) {
    LOG("[WDT] Failed to register task: %s", esp_err_to_name(ok));
  } else {
    LOG("[WDT] Watchdog timeout callback registered successfully");
  }
}

void esp_task_wdt_isr_user_handler(void){
  // Runs in interrupt context ("same limitations as an interrupt function", esp_task_wdt.h): no LOG(),
  // no Serial, no esp_restart(). LOG() takes locks and writes to the USB serial, which ended in an
  // Interrupt WDT panic and hid this line. esp_rom_printf is the interrupt-safe print; the reboot is
  // done by the IDF itself (trigger_panic in setup_wdt()).
  esp_rom_printf("[WDT] loop() did not run for %d s: stuck, rebooting\n", WATCHDOG_TIMEOUT_MS / 1000);
}
