CowboyTim/halloween-bang/tools/bench/run_tests.py

#!/usr/bin/env python3
"""Bench test of the Halloween Bang boards. Needs the TEST build on every board in the test:

  python3 bang.py deploy banger button killswitch explosion strobo --log --flags=-DTEST_SERIAL

(-DTEST_SERIAL reads one command per line on the USB serial: status | fire | lock | free; --log turns the
logging on, the test reads the log lines.) Never flash a TEST build to a board that is used for a show.

  python3 tools/bench/run_tests.py                       all tests
  python3 tools/bench/run_tests.py single_show           one test (see TESTS below)
  python3 tools/bench/run_tests.py repeat --shows 20     the repeat test with 20 shows

Boards are found by MAC from boards.toml. Each run's serial logs are saved in tools/bench/out/<time>/,
with a summary.txt. Exit status 1 if any check failed.
"""

import argparse
import datetime
import os
import re
import sys
import threading
import time

ROOT = os.path.abspath(os.path.join(os.path.dirname(__file__), "..", ".."))
sys.path.insert(0, ROOT)
import bang  # noqa: E402  (boards.toml, port lookup by MAC)

OUT_DIR = os.path.join(os.path.dirname(os.path.abspath(__file__)), "out")

# lines that mean a board reset or crashed; any of them fails the test that saw it
RESET_RE = re.compile(r"rst:|Guru Meditation|Brownout|panic|abort\(\)|Task watchdog|WDT|Backtrace")

# the show as the BANGER logs it: a full show is about 14 s; outside 12-17 s something is wrong
SHOW_MIN_MS, SHOW_MAX_MS = 12000, 17000
HEAP_DROP_MAX = 0.05       # free heap may fall at most 5 % over a run of shows
FRAME_GAP_MAX_MS = 300     # the strip's longest stall between two frames (a stall is a frozen strip)
HOST_SYNC_S = 0.5          # two boards' events that should be simultaneous: host arrival times within this


class Board:
    def __init__(self, cfg, port, out_dir):
        self.name, self.role, self.port = cfg["name"], cfg["role"], port
        self.lines = []                # (host time, text)
        self.lock = threading.Lock()
        self.log = open(os.path.join(out_dir, cfg["name"] + ".log"), "w", encoding="utf-8")
        self.ser = None

    def start(self, stop):
        import serial
        self.ser = serial.Serial(self.port, 115200, timeout=0.2)
        # opening raises DTR and RTS (no reset): clear RTS first, as bang.py monitor does
        self.ser.rts = False
        self.ser.dtr = False
        self.thread = threading.Thread(target=self._read, args=(stop,), daemon=True)
        self.thread.start()

    def _read(self, stop):
        buf = b""
        while not stop.is_set():
            try:
                buf += self.ser.read(4096)
            except Exception:
                return
            *lines, buf = buf.split(b"\n")
            for raw in lines:
                text = raw.decode("utf-8", "replace").rstrip("\r")
                now = time.monotonic()
                with self.lock:
                    self.lines.append((now, text))
                self.log.write(f"{now:.3f} {text}\n")
                self.log.flush()

    def send(self, cmd):
        self.ser.write((cmd + "\n").encode())
        self.ser.flush()

    def since(self, t):
        with self.lock:
            return [(ht, tx) for ht, tx in self.lines if ht >= t]

    def find(self, pattern, t):
        """First line at or after host time t that matches pattern: (host time, match) or None."""
        rx = re.compile(pattern)
        for ht, tx in self.since(t):
            m = rx.search(tx)
            if m:
                return ht, m
        return None

    def wait(self, pattern, t, timeout):
        """Wait until pattern shows up after t. Returns (host time, match) or None on timeout."""
        deadline = time.monotonic() + timeout
        while True:
            hit = self.find(pattern, t)
            if hit:
                return hit
            if time.monotonic() > deadline:
                return None
            time.sleep(0.05)


class Checks:
    def __init__(self):
        self.results = []             # (test, ok, text)
        self.test = ""

    def check(self, ok, text):
        self.results.append((self.test, bool(ok), text))
        print(f"  [{'PASS' if ok else 'FAIL'}] {text}", flush=True)
        return ok

    def begin(self, test):
        self.test = test
        print(f"\n== {test}", flush=True)


def role_board(boards, role):
    """The board of a role (the one BUTTON that is plugged in, the BANGER)."""
    for b in boards.values():
        if b.role == role:
            return b
    return None


def boards_of(boards, role):
    return [b for b in boards.values() if b.role == role]


LAST_FIRE = [0.0]      # host time of the last show started from the BUTTON
# WAIT_TIME_BUTTON and SHOW_COOLDOWN_MS of the firmware, read from the status replies (seconds)
TIMING = {"wait": 16.0, "cooldown": 60.0}


def button_cycle():
    """A press after a show counts only after WAIT_TIME_BUTTON + SHOW_COOLDOWN_MS (+1 s margin)."""
    return TIMING["wait"] + TIMING["cooldown"] + 1


BANGER_REF = [None]


def wait_banger_ready():
    """Wait until the BANGER's cooldown after its last show is over (it drops every BANG until then)."""
    banger = BANGER_REF[0]
    if not banger:
        return
    starts = [ht for ht, tx in banger.since(0) if "cooldown: " in tx]
    if starts and not banger.find(r"cooldown over", starts[-1]):
        print("  (waiting for the BANGER's cooldown)", flush=True)
        banger.wait(r"cooldown over", starts[-1], TIMING["cooldown"] + 30)
        time.sleep(0.5)


def wait_button_ready():
    """Wait out the BUTTON's show + cooldown after the last show it started, and the BANGER's cooldown."""
    if LAST_FIRE[0]:
        left = LAST_FIRE[0] + button_cycle() - time.monotonic()
        if left > 0:
            print(f"  (waiting {left:.0f} s for the BUTTON's show + cooldown)", flush=True)
            time.sleep(left)
    wait_banger_ready()


# ---- tests --------------------------------------------------------------------------------------

def test_status(boards, c):
    c.begin("status: every board runs the TEST build")
    t = time.monotonic()
    for b in boards.values():
        b.send("status")
    for b in boards.values():
        hit = b.wait(rf"TEST status role={b.role} reset=(\w+) heap=(\d+) wait=(\d+) cooldown=(\d+)", t, 3)
        c.check(hit, f"{b.name} ({b.role}) answers status" + ("" if hit else " - no answer: is it the TEST build?"))
        if hit:
            TIMING["wait"], TIMING["cooldown"] = int(hit[1].group(3)) / 1000, int(hit[1].group(4)) / 1000
            reset = hit[1].group(1)
            # brownout / panic / watchdog since the last flash = the board was reset by something: say so
            c.check(reset not in ("brownout", "panic", "wdt", "glitch"),
                    f"{b.name} last reset: {reset} (heap {hit[1].group(2)} bytes)")
    return True


def show_events(boards, t0, c, banger, expl, strobo):
    """Checks one show started at host time t0; returns the BANGER's show duration in ms (or None)."""
    dur = None
    hit = banger.wait(r"SHOW start", t0, 3)
    c.check(hit, "BANGER starts the show")
    hit = banger.wait(r"SHOW done ms=\d+ duration=(\d+)", t0, 25)
    if c.check(hit, "BANGER finishes the show"):
        dur = int(hit[1].group(1))
        c.check(SHOW_MIN_MS <= dur <= SHOW_MAX_MS, f"show length {dur} ms (expected {SHOW_MIN_MS}-{SHOW_MAX_MS})")
    for b in expl:
        for n in (1, 2):
            hit = b.wait(rf"SND{n} received", t0, 3)
            c.check(hit, f"{b.name} gets SND{n}")
    for b in strobo:
        hit = b.wait(r"STRB: flash on", t0, 3)
        c.check(hit, f"{b.name} fires its flash")
    return dur


def test_single_show(boards, c):
    c.begin("single_show: one show from the BUTTON, every box gets its message")
    button = role_board(boards, "BUTTON")
    banger = role_board(boards, "BANGER")
    expl, strobo = boards_of(boards, "EXPLOSION"), boards_of(boards, "STROBO")
    t0 = time.monotonic()
    button.send("fire")
    LAST_FIRE[0] = t0
    show_events(boards, t0, c, banger, expl, strobo)
    # the box events must come within HOST_SYNC_S of the BANGER sending them
    sent = banger.find(r"SND1 sent", t0)
    for b in expl:
        got = b.find(r"SND1 received", t0)
        if sent and got:
            d = got[0] - sent[0]
            c.check(abs(d) <= HOST_SYNC_S, f"{b.name} SND1 {d*1000:+.0f} ms against the BANGER's send")
    sent = banger.find(r"STRB sent", t0)
    for b in strobo:
        got = b.find(r"STRB: flash on", t0)
        if sent and got:
            d = got[0] - sent[0]
            c.check(abs(d) <= HOST_SYNC_S, f"{b.name} flash {d*1000:+.0f} ms against the BANGER's STRB")
    for n in (1, 2):
        hit = banger.find(rf"Animation LED {n}: DONE frames=(\d+) max_gap=(\d+)", t0)
        if c.check(hit and int(hit[1].group(1)) > 0, f"animation {n} ran ({hit[1].group(1) if hit else 'no DONE line'} frames)" if not hit else f"animation {n} ran {hit[1].group(1)} frames"):
            gap = int(hit[1].group(2))
            c.check(gap < FRAME_GAP_MAX_MS, f"animation {n}: longest stall between two frames {gap} ms (limit {FRAME_GAP_MAX_MS})")
    reset = [tx for b in boards.values() for _, tx in b.since(t0) if RESET_RE.search(tx)]
    c.check(not reset, "no reset or crash during the show" + (f": {reset[0]}" if reset else ""))


def test_repeat(boards, c, shows):
    c.begin(f"repeat: {shows} shows from the BANGER, each after the cooldown (the 'few tries' failure)")
    banger = role_board(boards, "BANGER")
    expl, strobo = boards_of(boards, "EXPLOSION"), boards_of(boards, "STROBO")
    durations, heaps = [], []
    wait_banger_ready()
    for i in range(1, shows + 1):
        t0 = time.monotonic()
        banger.send("fire")
        ok_before = len(c.results)
        dur = show_events(boards, t0, c, banger, expl, strobo)
        # the per-show checks above print a lot: keep only the failures of this show
        failed = [r for r in c.results[ok_before:] if not r[1]]
        print(f"  show {i}: {'ok' if not failed else 'FAILED'}" + (f", {dur} ms" if dur else ""), flush=True)
        if dur:
            durations.append(dur)
        hit = banger.find(r"SHOW done .* heap=(\d+)", t0)
        if hit:
            heaps.append(int(hit[1].group(1)))
        if i < shows:
            banger.wait(r"cooldown over", t0, TIMING["cooldown"] + 30)
            time.sleep(1)
    reset = [tx for b in boards.values() for _, tx in b.since(0) if RESET_RE.search(tx)]
    c.check(not reset, f"no reset or crash in {shows} shows" + (f": {reset[0]}" if reset else ""))
    if len(heaps) > 1:
        drop = heaps[0] - heaps[-1]
        c.check(drop < HEAP_DROP_MAX * heaps[0],
                f"free heap after {shows} shows: {heaps[0]} -> {heaps[-1]} bytes (drop {drop}, limit {HEAP_DROP_MAX:.0%})")
    if durations:
        print(f"  show length: min {min(durations)} ms, max {max(durations)} ms", flush=True)


def test_lock(boards, c):
    c.begin("lock: a KILLSWITCH lock locks the BUTTON, the unlock (FREE) unlocks it")
    button = role_board(boards, "BUTTON")
    ks = role_board(boards, "KILLSWITCH")
    wait_button_ready()
    t = time.monotonic()
    ks.send("lock")
    c.check(ks.wait(r"KILLSWITCH locked: sending LOCK", t, 3), "KILLSWITCH enters locked mode and sends LOCK")
    c.check(button.wait(r"killswitch held, button locked", t, 3), "BUTTON is locked")
    t = time.monotonic()
    button.send("fire")
    c.check(not button.wait(r"ADHD style sending BANG", t, 2), "BUTTON ignores a press while locked")
    t = time.monotonic()
    ks.send("free")
    c.check(ks.wait(r"KILLSWITCH unlocked: sending FREE", t, 3), "KILLSWITCH sends FREE")
    c.check(button.wait(r"lock ended \(LOCKs stopped or FREE\)", t, 3), "BUTTON is unlocked")
    t = time.monotonic()
    button.send("fire")
    LAST_FIRE[0] = t
    c.check(button.wait(r"ADHD style sending BANG", t, 3), "BUTTON fires again after the release")
    banger = role_board(boards, "BANGER")
    banger.wait(r"SHOW done", t, 25)


def test_lock_during_show(boards, c):
    c.begin("lock_during_show: a lock during the show does not stop it; the BUTTON locks after the cooldown if held")
    button = role_board(boards, "BUTTON")
    ks = role_board(boards, "KILLSWITCH")
    banger = role_board(boards, "BANGER")
    wait_button_ready()
    t0 = time.monotonic()
    button.send("fire")
    LAST_FIRE[0] = t0
    c.check(button.wait(r"ADHD style sending BANG", t0, 3), "show requested from the BUTTON")
    time.sleep(2)
    ks.send("lock")                      # a lock during the show
    hit = banger.wait(r"SHOW done ms=\d+ duration=(\d+)", t0, 25)
    c.check(hit and SHOW_MIN_MS <= int(hit[1].group(1)) <= SHOW_MAX_MS,
            "the show ran to the end while locked")
    # the lock stays on (no timer): the BUTTON is locked when its show + cooldown is over
    hit = button.wait(r"BUTTON state 3 -> 0", t0, button_cycle() + 10)
    c.check(hit, "BUTTON locks when the show + cooldown is over (still locked)")
    ks.send("free")
    c.check(button.wait(r"lock ended \(LOCKs stopped or FREE\)", t0, 3), "BUTTON unlocks on FREE")


def test_lock_hold(boards, c):
    c.begin("lock_hold: a lock has no timer: still locked after 35 s, unlocked by FREE")
    button = role_board(boards, "BUTTON")
    ks = role_board(boards, "KILLSWITCH")
    t = time.monotonic()
    ks.send("lock")
    c.check(button.wait(r"killswitch held, button locked", t, 3), "BUTTON is locked")
    time.sleep(35)
    c.check(not button.find(r"lock ended", t), "BUTTON is still locked after 35 s")
    c.check(not ks.find(r"KILLSWITCH unlocked", t), "KILLSWITCH is still locked after 35 s")
    ks.send("free")
    c.check(button.wait(r"lock ended \(LOCKs stopped or FREE\)", t, 3), "BUTTON unlocks on FREE")


def test_mash_button(boards, c):
    c.begin("mash_button: 30 presses during a show and its wait make exactly one show")
    button = role_board(boards, "BUTTON")
    banger = role_board(boards, "BANGER")
    wait_button_ready()
    t0 = time.monotonic()
    LAST_FIRE[0] = t0
    for _ in range(30):
        button.send("fire")
        time.sleep(0.2)
    time.sleep(max(0, t0 + button_cycle() - time.monotonic()))     # past the BUTTON's show + cooldown
    bangs = len([1 for _, tx in button.since(t0) if "ADHD style sending BANG" in tx])
    shows = len([1 for _, tx in banger.since(t0) if "SHOW start" in tx])
    c.check(bangs == 1, f"the BUTTON sent BANG {bangs} time(s) for 30 presses (expected 1)")
    c.check(shows == 1, f"the BANGER started {shows} show(s) (expected 1)")


def test_lock_storm(boards, c):
    c.begin("lock_storm: 20 quick lock/free cycles leave the BUTTON unlocked and working")
    button = role_board(boards, "BUTTON")
    ks = role_board(boards, "KILLSWITCH")
    wait_button_ready()
    t0 = time.monotonic()
    for _ in range(20):
        ks.send("lock")
        time.sleep(0.25)
        ks.send("free")
        time.sleep(0.25)
    time.sleep(1)
    t = time.monotonic()
    button.send("fire")
    LAST_FIRE[0] = t
    c.check(button.wait(r"ADHD style sending BANG", t, 3), "the BUTTON fires after the storm (not stuck locked)")


def test_lock_press_race(boards, c):
    c.begin("lock_press_race: a lock and a press within 50 ms, 3 times: the BUTTON never ends up stuck")
    button = role_board(boards, "BUTTON")
    ks = role_board(boards, "KILLSWITCH")
    for i in range(1, 4):
        wait_button_ready()
        t = time.monotonic()
        ks.send("lock")
        time.sleep(0.05)
        button.send("fire")
        time.sleep(0.5)
        ks.send("free")
        time.sleep(1)
        if button.find(r"ADHD style sending BANG", t):
            LAST_FIRE[0] = t                 # the press won the race: a show + cooldown to wait out
        ok = button.find(r"lock ended", t) or button.find(r"ADHD style sending BANG", t)
        c.check(ok, f"round {i}: the BUTTON is unlocked after the release")
    wait_button_ready()
    t = time.monotonic()
    button.send("fire")
    LAST_FIRE[0] = t
    c.check(button.wait(r"ADHD style sending BANG", t, 3), "the BUTTON fires after the races")


def count(board, text, t):
    return len([1 for _, tx in board.since(t) if text in tx])


def test_button_glitch(boards, c):
    c.begin("button_glitch: noise spikes on the button pin (interrupt edges, pin HIGH again) start no show")
    button = role_board(boards, "BUTTON")
    banger = role_board(boards, "BANGER")
    wait_button_ready()
    t0 = time.monotonic()
    for _ in range(20):
        button.send("glitch")
        time.sleep(0.05)
    time.sleep(3)
    c.check(count(button, "ADHD style sending BANG", t0) == 0, "no BANG from 20 glitches")
    c.check(count(banger, "SHOW start", t0) == 0, "no show on the BANGER")
    c.check(button.wait(r"short glitch\(es\) ignored", t0, 12), "the BUTTON logs the ignored glitches")


def test_button_stuck(boards, c):
    c.begin("button_stuck: a button stuck down starts ONE show, not one after every cooldown")
    button = role_board(boards, "BUTTON")
    banger = role_board(boards, "BANGER")
    wait_button_ready()
    t0 = time.monotonic()
    button.send("hold")
    LAST_FIRE[0] = t0
    stuck_s = button_cycle() + 20        # past one whole show + cooldown while stuck
    c.check(button.wait(r"stuck\?", t0, 5), "the BUTTON reports the stuck button (its lamp flickers)")
    time.sleep(max(0, t0 + stuck_s - time.monotonic()))
    bangs = count(button, "ADHD style sending BANG", t0)
    shows = count(banger, "SHOW start", t0)
    c.check(bangs == 1, f"the BUTTON sent BANG {bangs} time(s) in {stuck_s:.0f} s stuck (expected 1)")
    c.check(shows == 1, f"the BANGER started {shows} show(s) (expected 1)")
    t = time.monotonic()
    button.send("release")
    time.sleep(1)
    c.check(count(button, "ADHD style sending BANG", t) == 0, "letting go is not a press")
    c.check(button.find(r"button let go", t), "the BUTTON reports that it was let go")
    t = time.monotonic()
    button.send("fire")
    LAST_FIRE[0] = t
    c.check(button.wait(r"ADHD style sending BANG", t, 3), "a real press after the release starts a show")


def test_button_chatter(boards, c):
    c.begin("button_chatter: a chattering contact (5 ms on/off) for 20 s starts no show")
    button = role_board(boards, "BUTTON")
    banger = role_board(boards, "BANGER")
    wait_button_ready()
    t0 = time.monotonic()
    button.send("chatter")
    time.sleep(20)
    button.send("release")
    time.sleep(1)
    c.check(count(button, "ADHD style sending BANG", t0) == 0, "no BANG from 20 s of chatter")
    c.check(count(banger, "SHOW start", t0) == 0, "no show on the BANGER")


def test_cooldown(boards, c):
    c.begin("cooldown: after a show the BANGER drops BANGs for SHOW_COOLDOWN_MS, then starts fresh")
    banger = role_board(boards, "BANGER")
    wait_banger_ready()
    t0 = time.monotonic()
    banger.send("fire")
    hit = banger.wait(r"SHOW done", t0, 25)
    c.check(hit, "first show done")
    t = time.monotonic()
    banger.send("fire")                  # inside the cooldown
    c.check(banger.wait(r"BANG ignored: cooldown", t, 3), "a BANG in the cooldown is dropped")
    c.check(not banger.wait(r"SHOW start", t, 3), "no second show in the cooldown")
    hit = banger.wait(r"cooldown over", t0, TIMING["cooldown"] + 30)
    if hit and c.check(hit, "the cooldown ends"):
        done = banger.find(r"SHOW done", t0)
        if done:
            d = hit[0] - done[0]
            c.check(abs(d - TIMING["cooldown"]) < 2, f"cooldown lasted {d:.1f} s (expected {TIMING['cooldown']:.0f})")
    t = time.monotonic()
    banger.send("fire")
    c.check(banger.wait(r"SHOW start", t, 3), "a BANG after the cooldown starts a show")
    banger.wait(r"cooldown over", t, TIMING["cooldown"] + 30)


TESTS = {
    "single_show": (test_single_show, ["BUTTON", "BANGER"]),
    "repeat": (test_repeat, ["BANGER"]),
    "cooldown": (test_cooldown, ["BANGER"]),
    "mash_button": (test_mash_button, ["BUTTON", "BANGER"]),
    "button_glitch": (test_button_glitch, ["BUTTON", "BANGER"]),
    "button_stuck": (test_button_stuck, ["BUTTON", "BANGER"]),
    "button_chatter": (test_button_chatter, ["BUTTON", "BANGER"]),
    "lock_storm": (test_lock_storm, ["BUTTON", "KILLSWITCH"]),
    "lock_press_race": (test_lock_press_race, ["BUTTON", "KILLSWITCH"]),
    "lock": (test_lock, ["BUTTON", "KILLSWITCH"]),
    "lock_during_show": (test_lock_during_show, ["BUTTON", "BANGER", "KILLSWITCH"]),
    "lock_hold": (test_lock_hold, ["BUTTON", "KILLSWITCH"]),
}
ORDER = ["single_show", "repeat", "cooldown", "mash_button", "button_glitch", "button_stuck", "button_chatter", "lock", "lock_storm", "lock_press_race", "lock_during_show", "lock_hold"]


def main():
    p = argparse.ArgumentParser(description=__doc__, formatter_class=argparse.RawDescriptionHelpFormatter)
    p.add_argument("tests", nargs="*", help=f"tests to run: {', '.join(ORDER)} (default: all)")
    p.add_argument("--shows", type=int, default=4, help="shows in the repeat test (default 4; each waits out the cooldown)")
    args = p.parse_args()
    names = args.tests or ORDER
    for n in names:
        if n not in TESTS:
            p.error(f"unknown test {n}")

    cfg = bang.load_boards()
    present = {mac: dev for dev, mac, _ in bang.list_ports()}
    wanted = {"BANGER", "BUTTON", "KILLSWITCH", "EXPLOSION", "STROBO"}
    # every connected board of these roles, but only one BUTTON (a spare is not tested alongside it)
    boards_cfg = {}
    button_taken = False
    for b in cfg.values():
        if b["role"] not in wanted or b["mac"] not in present:
            continue
        if b["role"] == "BUTTON":
            if button_taken:
                continue
            button_taken = True
        boards_cfg[b["name"]] = b
    if not boards_cfg:
        sys.exit("no boards connected (see bang.py list)")
    need = set(r for n in names for r in TESTS[n][1])
    missing = sorted(r for r in need if not any(b["role"] == r for b in boards_cfg.values()))
    if missing:
        sys.exit(f"not connected: {', '.join(missing)}")

    stamp = datetime.datetime.now().strftime("%Y%m%d-%H%M%S")
    out_dir = os.path.join(OUT_DIR, stamp)
    os.makedirs(out_dir, exist_ok=True)
    stop = threading.Event()
    boards = {}
    for key, b in boards_cfg.items():
        boards[key] = Board(b, present[b["mac"]], out_dir)
        boards[key].start(stop)
    time.sleep(1.5)                  # let the boards print their boot lines

    c = Checks()
    BANGER_REF[0] = role_board(boards, "BANGER")
    print(f"boards: {', '.join(f'{b.name} ({b.role}) on {b.port}' for b in boards.values())}")
    print(f"logs: {out_dir}")
    test_status(boards, c)
    for n in names:
        fn, _ = TESTS[n]
        if n == "repeat":
            fn(boards, c, args.shows)
        else:
            fn(boards, c)
    stop.set()

    failed = [r for r in c.results if not r[1]]
    summary = [f"{t}: {'PASS' if ok else 'FAIL'} - {txt}" for t, ok, txt in c.results]
    with open(os.path.join(out_dir, "summary.txt"), "w", encoding="utf-8") as f:
        f.write("\n".join(summary) + "\n")
    print(f"\n{len(c.results) - len(failed)} of {len(c.results)} checks passed. Summary: {out_dir}/summary.txt")
    sys.exit(1 if failed else 0)


if __name__ == "__main__":
    main()
