CowboyTim/halloween-bang/(commit log)

2026-10-10 add JDY button + fixes
2026-10-11 setup_button.sh: JDy-40 board config
2026-10-12 ledstrip sparkly fuse dynamite plunger animation
2026-10-12 ledstrip fuse improve
2026-10-12 right, onboard pixel led wont work
2026-10-12 slightly slower led animation
2026-10-13 led animation clear between 2 + ISR for button so we can be more idle
2026-10-13 add logging, reduce cpu for button, reduce delay for button
2026-10-13 logging print fix
2026-10-13 Update README.md with board GPIO pinout requirements (ESP32 S3 Zero for BANGER, S3 SuperMini for BUTTON)
2026-10-13 Add 12V LED control for BUTTON mode: turns off on press, configurable wait time
2026-10-13 Add ESP32 S3 pinout diagrams (SuperMini and Zero)
2026-10-13 Update 12V LED control and wait time: GPIO_NUM_7 for LED, 3000ms wait, LED ON after wait
2026-10-13 Convert remaining Serial.print/println to LOG() macro
2026-10-13 Change Serial.begin to UART0.begin for LOG() compatibility
2026-10-13 Refactor: separate BANGER/BUTTON setup/loop with WHAT mode variable
2026-10-13 Update run_ledstrip_animation_2(): increased brightness, tail minus 40 LEDs
2026-10-13 Fix LED color order: WS2812RGB -> WS2812GRB for correct RGB output
2026-10-13 add button LED disable at press again
2026-10-13 Replace delay(WAIT_TIME_BUTTON) with blinking LED while loop
2026-10-13 halloween-bang/halloween-bang.ino: improve led flicker
2026-10-13 docs/button_schema.jpeg added
2026-10-13 let's use the entire ledstrip
2026-10-14 document fuse and ring show, raise button wait to 16s
    Claude-Session: https://claude.ai/code/session_01UeAtLpyDy2zpyFZ7QaNSHi
2026-10-14 add strobe LED burst on KABOOM (GPIO 5 via MOSFET), document wiring and power
    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
2026-10-14 document COB strobe LED choice and series resistors
    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
2026-10-14 document D4184 MOSFET trigger module for the strobe
    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
2026-10-14 button: discard presses made during the show
    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
2026-10-14 Add KILLSWITCH mode, BUTTON arming state machine and lamp animations, schematics
    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
2026-10-14 Make KILLSWITCH optional: BUTTON works alone, first LOCK guards it
    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
2026-10-14 BUTTON: unlock by itself 30 s after a show unless the actor LOCKed
    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
2026-10-14 remove MAC address log (prints zeros before the Wi-Fi interface is up)
    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
2026-10-14 BUTTON sends BANG 3x; BANGER drops copies that arrive during the show
    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
2026-10-14 docs: SVG schematics for BANGER and BUTTON, optional parts dashed
    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
2026-10-14 docs: 1000 uF strip capacitor is required, DFPlayer 1k optional
    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
2026-10-14 docs: arcade lamp is LED + 470 ohm in the BUTTON schematic
    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
2026-10-14 docs: battery power findings, hardware notes, strobe mounting
    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
2026-10-14 BANGER plays the light show without a working DFPlayer; feed WDT only in loop()
    DFPlayer init and every BUSY wait are bounded; on failure sound_ok = 0
    and the animations run on their own timers. doYIELD no longer resets
    the watchdog. Docs: BANGER and BUTTON verified on hardware, deploy
    commands with -ULOG_VERBOSE, logging needs -DLOG_VERBOSE.
2026-10-14 LOG() never blocks on USB serial when no monitor is reading
    HWCDC write() waited up to ~2 s per call with the PC plugged in but the
    monitor closed, stalling the BANG and the show. Zero TX timeout, 2 KB TX
    buffer, one write per line, and a line that does not fit is dropped.
2026-10-15 bang.py: build/flash/monitor boards by MAC from boards.toml
    The serial port of each board is found via its USB serial number (the MAC
    on native-USB ESP32-S3/C3), so swapped /dev/ttyACM* ports do not matter.
    esptool flashes with --chip from boards.toml and the MAC is re-checked.
    BUTTON/KILLSWITCH get the BANGER MAC as -DBANGER_MAC. Builds go to
    dist/<chip>/<role>/. KILLSWITCH is now an ESP32-C3 SuperMini: EdSoftLED
    uses 2 RMT blocks there so it compiles. build.sh is a wrapper.
2026-10-15 KILLSWITCH: hold-to-lock on an ESP32-C3 SuperMini
    The BUTTON always works, except while the killswitch is held: it then
    repeats LOCK every 150 ms and the BUTTON stays LOCKED only while those
    arrive (1 s timeout, 15 s max even if held). Release sends FREE.
    Replaces ARM / guarded / cooldown / COUNTDOWN and the S0..S3 status.
    KILLSWITCH pins per chip: on the C3 GPIO 3 button, on-board BOOT and
    blue LED; Wi-Fi TX power 8.5 dBm (at 20 dBm half the packets were lost).
    BANGER/BUTTON refuse a C3 build. Docs and schematics updated.
2026-10-15 boards.toml use different esp32c3 designed board, hopefully this is better
2026-10-15 KILLSWITCH: drop RANGE_TEST, keep 19.5 dBm TX power
    Remove the RANGE_TEST build (TX-power steps and RT packets) now that the
    range measurements are done. Keep the C3 Wi-Fi TX power at 19.5 dBm;
    reception at 7 m barely changed with power, so the 8.5 dBm setting was
    not kept. Update the TX power notes in the sketch, README and AGENTS.md.
2026-10-15 EXPLOSION: optional sound-only box, per-role volume, SD card guide
    A sound-only box (role EXPLOSION) plays the same 0001.mp3 / 0002.mp3 as
    the BANGER. The BANGER sends SND1 / SND2 just before it starts each sound
    and does not wait for the box; repeats within 1 s are ignored. Without
    the box, nothing changes (the BANGER gets its MAC only when it is listed
    in boards.toml with one).
    The DFPlayer volume is per role: BANGER 20, EXPLOSION 10 (lowered while it
    ran from the C3's 3.3 V pin). sound_setup() uses SOUND_VOLUME at boot.
    README: EXPLOSION mode, power from 5 V, SD card preparation for 16 GB
    (sd.txt shows the working partition layout), line-out note.
2026-10-15 Schematics: DFPlayer on 5 V needs 1 kohm on TX and BUSY
    The DFPlayer now runs from 5 V on the BANGER and the EXPLOSION box. Its
    TX and BUSY outputs can reach 5 V, and the S3/C3 pins are not 5 V
    tolerant, so each needs 1 kohm in series. BUSY gets no pull-down: the
    internal pull-up keeps it high while idle. The 1 kohm on ESP TX to
    DFPlayer RX stays optional.
    Add docs/explosion_schematic.svg (EXPLOSION box: C3 SuperMini, DFPlayer on
    5 V, 3 W speaker). Update docs/banger_schematic.svg and the README and
    AGENTS.md notes to match.
2026-10-16 EXPLOSION: DFPlayer search with LED; fix DFPlayer ACK hang and WDT handler
    EXPLOSION box: search for the DFPlayer from loop() every 5 s until it is
    found (the watchdog is fed between tries); built-in LED blinks while it
    is missing and is lit once it is found.
    DFPlayer library hazard: in ACK mode sendStack() can spin forever (a stale
    _isAvailable flag makes waitAvailable() return at once while a missing ACK
    keeps _isSending true), which froze the box at a cold power-up. Use ACK
    mode only for the detecting begin(), then begin(stream, false, false), so
    no later command can block. Also protects the BANGER's show.
    Watchdog: the user handler runs in interrupt context. Print with
    esp_rom_printf (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
2026-10-16 Docs: DFPlayer decoupling (470 uF + 100 nF), watchdog and library notes
    Show 470 uF / 16 V + 100 nF across the DFPlayer VCC/GND pins in the
    BANGER and EXPLOSION schematics. AGENTS.md: the watchdog now reboots on a
    stuck loop(), and the DFPlayer ACK-mode hazard. README: EXPLOSION LED
    behaviour and decoupling.
2026-10-16 EXPLOSION: flicker the built-in LED while a sound plays
    The LED already blinks while the DFPlayer is missing and is lit when the
    box is ready. Now it also flickers (random on/off every 50 ms) while a
    sound plays. The flicker follows the DFPlayer BUSY pin and starts at the
    play command, since BUSY goes low a moment later.
2026-10-16 BANGER: status LED on the S3 Zero's built-in WS2812
    Dim green when ready, orange flicker while the show runs, yellow blink
    while the DFPlayer is missing. The LED is a WS2812 on GPIO 21; it is
    bit-banged (about 30 us per write, interrupts off on this core) because
    the strip owns the RMT peripheral and neopixelWrite() fails. It is updated
    from myYIELD(), so it also runs inside the show's loops, and only written
    when the colour changes.
2026-10-16 tools: 433 MHz ASK link range test (STX882 / SRX882)
    Standalone bench test, not part of the show firmware: one sketch, built as
    transmitter (C3, -DRF_TX) or receiver (S3, -DRF_RX). The transmitter sends
    a numbered packet every 150 ms (the KILLSWITCH LOCK rate); the receiver
    prints every 4 s how many arrived and how many failed the CRC. README with
    wiring, build/flash commands and the procedure.
    Result with 17 cm wire antennas: 100% at 4 m, at 7 m through a wall and at
    10 m through two walls (ESP-NOW alone: 10-68% at 7 m).
2026-10-16 KILLSWITCH: 433 MHz second link; add STROBO box; several add-on boxes
    KILLSWITCH -> BUTTON now uses two links, either one is enough: every LOCK
    and FREE goes out over ESP-NOW and over a 433 MHz ASK link (RadioHead
    RH_ASK, STX882 on GPIO 4); the BUTTON polls an SRX882 (GPIO 6, 1 kohm in
    series) and feeds both links into the same lock timer, so a lost link can
    only shorten a lock. FREE is sent when the 433 MHz radio is idle, copies
    100 ms apart (a packet takes ~70 ms on the air). The BUTTON logs which
    links delivered a lock on release. USE_RF433 is on only in BUTTON and
    KILLSWITCH builds; bang.py update installs RadioHead.
    New STROBO role: a strobe-only add-on box. The BANGER sends "STRB" whe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
2026-10-16 bang.py: support spare boards (several boards per role)
    A role can have several boards in boards.toml (a spare BUTTON, several
    EXPLOSION or STROBO boxes). Selecting the role builds once and flashes
    whichever of its boards are plugged in, and says which it skipped. A board
    named exactly, or the only board of a role, must be connected. 'all' now
    skips boards that are not plugged in instead of failing.
    A name that is both a board and a role ('button') means the whole role once
    the role has more than one board, so 'deploy button' also reaches the spare.
    boards.toml: template for a spare BUTTON, notes on several boards per role.
2026-10-16 boards.toml: add mac of the spare BUTTON
2026-10-16 bang.py: install missing Arduino libraries before building
    A fresh machine has no libraries and the build failed with "RH_ASK.h: No
    such file or directory" (RadioHead is new for the BUTTON and KILLSWITCH).
    build_boards() now asks arduino-cli which libraries are installed and
    installs the missing ones the selected roles need: DFRobotDFPlayerMini for
    every role, RadioHead for BUTTON and KILLSWITCH. A failed install stops
    with the command to run.
2026-10-16 Schematics: fix overlaps found by rendering them; D4184 module notes
    Render every SVG (resvg) and fix what showed up: STROBO gate-resistor label
    hidden behind the MOSFET box and clipped notes; EXPLOSION resistors not
    touching their wires, notes over the GND wires and a clipped note; KILLSWITCH
    and BUTTON 433 MHz module details with overlapping labels, outdated free-pin
    note and the dropped countdown display box; BANGER footer, decoupling labels
    and a resistor label under a dashed box; system overview now shows the
    433 MHz link.
    STROBO: say that the D4184 trigger module needs no external gate network
    (on the module in use V+ is linked through, GND is switched, gate resistors
    are on the board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
2026-10-16 boards.toml: MAC of the STROBO board
2026-10-16 boards.yoml: strobo now EC:DA:3B:BF:93:94
2026-10-16 BUTTON: wired killswitch input (GPIO 2), OR'ed with the radio lock
2026-10-16 Wired killswitch: move to GPIO 1 (GPIO 2 not on the SuperMini pinout); bench test OK
2026-10-17 swap button and spare button mac address
2026-10-17 boards.toml: different killswitch
2026-10-20 AGENTS.md: strip capacitor 470 uF is enough at brightness 10
2026-10-20 docs: add on/off button with white LED drawing (KILLSWITCH switch)
2026-10-20 docs: remove button_schema.jpeg (superseded by button_schematic.svg)
2026-10-20 README: note on the on/off switch with white LED (3-6 V per shop page, not 12 V)
2026-10-20 KILLSWITCH: lock switch LED on GPIO 10 (mirrors the on-board LED), schematic and docs updated
2026-10-20 TODO: KILLSWITCH on USB-C + power bank, battery option in Won't do
2026-10-21 EXPLOSION: volume 20 like the BANGER (DFPlayer now on 5 V, line-out to an amp)
2026-10-23 STROBO schematic: 12 V brick with buck to 5 V, 3 LED chips with own resistors on one MOSFET
2026-10-27 BANGER: DFPlayer and own strobe out of the default build (-DBANGER_DFPLAYER for the DFPlayer); STROBO: one flash with PWM brightness
2026-10-27 Docs: BANGER without DFPlayer by default, STROBO one flash, BANGER strobe removed (AGENTS, README, schematics, TODO)
2026-10-27 Test build (-DTEST_SERIAL) and bench test runner over USB serial; DFPlayer detection without the library's ACK wait (EXPLOSION box hung with no DFPlayer); timestamps and frame counts in the logs
2026-10-27 STROBO: on-board LED goes dark for the flash (visible on USB-C power alone); bench test: wait out the BUTTON's 16 s before a press, accept the FREE as the BUTTON's unlock; test results
2026-10-27 boards.toml: comments updated (spare BUTTON active, STROBO is one flash, example box name)
2026-10-27 boards.toml: spare BUTTON now used for another project (MAC kept)
2026-10-27 Test build: reset reason and free heap in status, frame stall in the animation logs; bench suite: button mashing, lock storm, lock/press race, heap and stall checks
2026-10-29 Button cooldown and press filter, 600-LED strip, BANGER cooldown LED; power measurements
    BUTTON: a press counts only after 30 ms LOW and 50 ms released, stuck lamp flicker after 2 s.
    After each show, 60 s cooldown on both sides (BANGER drops BANG, BUTTON lamp dark).
    BANGER: dim blue LED during the cooldown, logs the sender MAC and BANG count.
    Strip: 600 LEDs, fuse 0-419 with FUSE_SCALE, ring 420-599 unchanged.
    Bench tests: cooldown, glitch, stuck and chatter checks; test build status shows wait and cooldown.
    README: power measurements from the inline USB meter.
2026-10-29 Lock expiry 30 s (LOCK_MAX_MS), docs and lock_expiry test
    KILLSWITCH stops LOCK after 30 s held and blinks fast; BUTTON ends the lock at the same time.
    Applies to the wired killswitch too. BANGER unchanged.
2026-10-30 STROBO: burst of 6 flashes on STRB (bounded: 80 ms on, 120 ms apart, 2 s hard stop)
    Repeat guard (5 s) stays; compile-time check that it is longer than the burst.
    On-board LED dark for the whole burst. README, AGENTS.md and strobo schematic updated.
2026-10-30 KILLSWITCH: ESP-NOW only, 433 MHz transmit path removed (STX882 not fitted)
    USE_RF433 is 1 only in BUTTON builds; the BUTTON keeps its SRX882 receiver path.
    Docs and schematics updated to match; the SVG text was not rendered.
2026-11-02 AGENTS.md: lock as a LOCK stream from the KILLSWITCH (dead-man switch), no timeout while it runs
    The KILLSWITCH toggles locked mode on each press and sends LOCK while locked; the BUTTON
    unlocks 1 s after the last LOCK or on FREE. Code not changed yet: the BUTTON still has the
    30 s radio expiry and the KILLSWITCH still uses hold-to-lock.
2026-11-04 KILLSWITCH: lock is a LOCK stream with no timer; press toggles
    The BUTTON lock has no timer of its own: it lasts while the KILLSWITCH
    sends LOCK (dead-man switch) and ends on FREE or LOCK_TIMEOUT_MS after
    the stream stops. The KILLSWITCH toggles locked mode on each press
    instead of locking while held. LOCK_MAX_MS is gone; the wired killswitch
    keeps its own WIRED_LOCK_MAX_MS expiry.
    Bench tests and docs follow: lock_expiry becomes lock_hold (no expiry
    after 35 s), lock_storm no longer checks for an expiry.
